UFelipeJR/CubeSat_UD34/README.md

# OBC del CubeSat UD34 — Práctica 4

**Integrantes:** José Manuel Arias Toro y Felipe Jiménez Ramírez  
**Universidad:** Universidad de Antioquia  
**Curso:** Laboratorio de Diseño de Productos Electrónicos  
**Herramienta:** Altium Designer 26

## Descripción

En esta práctica desarrollamos el esquema eléctrico de la tarjeta OBC (On-Board Computer) del CubeSat UD34. La tarjeta utiliza el STM32N657X0H3Q para coordinar el procesamiento, el almacenamiento de datos, el manejo de la cámara, los buses de comunicación y el monitoreo de alimentación.

Separamos el circuito en una hoja principal y varias hojas por función: alimentación, núcleo del MCU, SDRAM, almacenamiento, interfaz de cámara, buses de sistema, supervisión y conector de apilamiento. Las interfaces CAN-FD e I²C utilizan hojas reutilizables con instancias independientes.

## Archivos de soporte

Todos los archivos requeridos estan en la carpeta Archivos

## Proyecto de Altium

El proyecto nativo se abre con desde archivos y descomprimiendo 00_Proyecto_nativo.zip, este contiene `p4_v07_Arias_Jimenez.PrjPcb` desde Altium Designer 26. La hoja raíz es `00_OBC_Top.SchDoc`. Las ocho hojas funcionales y las dos subhojas repetidas forman parte del mismo proyecto.Todas las librerias externas estan en 04_Librerias

## 💡 Indice
- [📄 Archivos ](Archivos)
