UFelipeJR/CubeSat_UD34/Archivos/02_BOM_y_Costos/BOM_Altium_Exportada.xlsx

Name | Description | Designator | Footprint | LibRef | Quantity | Value | Manufacturer | Manufacturer Part Number
0Ω | Chip Resistor, 10 KOhm, +/- 1%, 0.1 W, -55 to 155 degC, 0402 (1005 Metric), RoHS, Tape and Reel | R712 | RESC1005X40X25LL05T05 | CMP-2000-07588-1 | 1 |  | Panasonic
1kΩ, | RES 1kΩ ±0.5% 0.063W 0402 | R18 | FP-AC0402-IPC_A | CMP-03412-044280-1 | 1
1nF | Chip Capacitor, 1 nF, +/- 10%, 50 V, -55 to 125 degC, 0402 (1005 Metric), RoHS, Tape and Reel | C12, C13 | CAPC1005X55X25ML5T10 | CMP-1662-00017-1 | 2
1nF | Chip Multilayer Ceramic Capacitors for General Purpose, 0402, 0.10uF, X7R, 15%, 10%, 50V | C303, C304, C305 | FP-GRM155-0_05-IPC_B | CMP-2008-04639-2 | 3
1uF | Multilayer Ceramic Capacitors 1μF ±10% 16V X7R SMD 0603 | C6, C7, C8, C9, C10, C11, C22, C23, C30, C31, C32, C33, C34, C35, C36, C37, C38, C58, C59 | FP-C1608-080-0_1-IPC_B | CMP-08246-002727-1 | 19
1uH | FIXED IND 1UH 4A 37 MOHM SMD | L2 | INDC3225X120N | TFM322512ALVA1R0MTAA | 1
2,2kΩ | Chip Resistor, 10 KOhm, +/- 1%, 0.1 W, -55 to 155 degC, 0402 (1005 Metric), RoHS, Tape and Reel | R502, R503, R504, R505, R511, R512, R605_I2C_ADCS, R605_I2C_SYS, R606_I2C_ADCS, R606_I2C_SYS, R607_I2C_ADCS, R607_I2C_SYS, R608_I2C_ADCS, R608_I2C_SYS | RESC1005X40X25LL05T05 | CMP-2000-07588-1 | 14 |  | Panasonic
2,2nF | Chip Multilayer Ceramic Capacitors for General Purpose, 0402, 2200pF, X7R, 15%, 10%, 50V | C39 | FP-GRM155-0_05-IPC_B | CMP-2008-04653-5 | 1
2,2uF | Multilayer Ceramic Capacitors 4.7μF ±10% 10V X7R SMD 0805 | C316 | FP-C2012-125-0_2-IPC_B | CMP-08246-006484-1 | 1
2N7002 | MOSFET N-CH 60V 0.3A SOT23 | Q501 | FP-PG-SOT23-3-MFG | CMP-32901-000180-1 | 1
2Ω |  | R14 | RESC1005X40X25NL05T10 | CMP-2002-07059-1 | 1 |  | Yageo / Phycomp
2.2uH | Fixed Inductors 2.2uH Shld 20% 5.5A 38.7mOhms AECQ2 | L1 | FP-XAL4020-MFG | CMP-11268-000134-1 | 1
3,3nF |  | C5 | CAPC1005X55X25ML05T10 | CMP-2008-04658-1 | 1 |  | Murata
3.32 kΩ | Chip Resistor, 10 KOhm, +/- 1%, 0.1 W, -55 to 155 degC, 0402 (1005 Metric), RoHS, Tape and Reel | R2 | RESC1005X40X25LL05T05 | CMP-2000-07588-1 | 1 |  | Panasonic
4,7nF | Chip Multilayer Ceramic Capacitors for General Purpose, 0402, 0.10uF, X7R, 15%, 10%, 50V | C602_CAN_A, C602_CAN_B | FP-GRM155-0_05-IPC_B | CMP-2008-04639-2 | 2
4,7uF | Multilayer Ceramic Capacitors 4.7μF ±10% 10V X7R SMD 0805 | C40, C215, C216, C310 | FP-C2012-125-0_2-IPC_B | CMP-08246-006484-1 | 4
8,2pF | CAP CER 8.2PF 50V C0G/NP0 0402 | C62, C63, C64, C65 | FP-GRM155-0_05-MFG | CMP-2008-03919-2 | 4
10k | Chip Resistor, 10 KOhm, +/- 1%, 0.1 W, -55 to 155 degC, 0402 (1005 Metric), RoHS, Tape and Reel | R9, R15, R16 | RESC1005X40X25LL05T05 | CMP-2000-07588-1 | 3 |  | Panasonic
10kΩ | Chip Resistor, 10 KOhm, +/- 1%, 0.1 W, -55 to 155 degC, 0402 (1005 Metric), RoHS, Tape and Reel | R202, R301, R302, R303, R304, R305, R306, R307, R308, R309, R310, R311, R312, R313, R314, R315, R316, R506, R507, R508, R509, R510, R609_I2C_ADCS, R609_I2C_SYS, R701, R702, R704, R707, R709, R710, R711 | RESC1005X40X25LL05T05 | CMP-2000-07588-1 | 31 |  | Panasonic
10nF | Chip Multilayer Ceramic Capacitors for General Purpose, 0402, 0.10uF, X7R, 15%, 10%, 50V | C505, C507 | FP-GRM155-0_05-IPC_B | CMP-2008-04639-2 | 2
10nF | Chip Multilayer Ceramic Capacitors for General Purpose, 0402, 10000pF, X7R, 15%, 10%, 50V | C61 | FP-GRM155-0_05-IPC_C | CMP-2008-04637-5 | 1
10uF | Multilayer Ceramic Capacitors 10μF ±10% 10V X7R SMD 0805 | C1, C3, C20, C21 | FP-C2012-125-0_2-MFG | CMP-2000-05452-2 | 4
15uF | Multi-Layer Ceramic Capacitor 15uF 6.3V X5R ±10% 1206 Emboss T/R | C26, C27, C28, C29 | FP-GRT31C-0_2-IPC_B | CMP-06035-045968-1 | 4
22uF | Multilayer Ceramic Capacitors 22μF ±20% 10V X7S SMD 0805 | C4 | FP-C2012-125-0_2-IPC_B | CMP-08246-005250-1 | 1
22Ω | Chip Resistor, 10 KOhm, +/- 1%, 0.1 W, -55 to 155 degC, 0402 (1005 Metric), RoHS, Tape and Reel | R201 | RESC1005X40X25LL05T05 | CMP-2000-07588-1 | 1 |  | Panasonic
24MHz | Crystals 24MHz 20ppm 8pF -40C +125C | X1 | ECS240833QJESTR | ECS-240-8-33Q-JES-TR | 1
30,1kΩ | Chip Resistor, 10 KOhm, +/- 1%, 0.1 W, -55 to 155 degC, 0402 (1005 Metric), RoHS, Tape and Reel | R706, R708 | RESC1005X40X25LL05T05 | CMP-2000-07588-1 | 2 |  | Panasonic
32,768kHz | Crystals 32.768 kHz 7.0 pF +/-20 PPM AEC-Q200 | X2 | XTAL_CM7V-T1A-32.768K-7PF-20PPM-TB-QA | CM7V-T1A-32.768K-7PF-20PPM-TB-QA | 1
50m | RES 0.05 OHM 1% 1W 2512 | R1 | FP-WSL2512-MFG | CMP-2000-07420-2 | 1 | 50mΩ | Vishay | WSL2512R0500FEA
60,4Ω | Chip Resistor, 10 KOhm, +/- 1%, 0.1 W, -55 to 155 degC, 0402 (1005 Metric), RoHS, Tape and Reel | R601_CAN_A, R601_CAN_B, R602_CAN_A, R602_CAN_B | RESC1005X40X25LL05T05 | CMP-2000-07588-1 | 4 |  | Panasonic
100 kΩ | Chip Resistor, 10 KOhm, +/- 1%, 0.1 W, -55 to 155 degC, 0402 (1005 Metric), RoHS, Tape and Reel | R4, R6 | RESC1005X40X25LL05T05 | CMP-2000-07588-1 | 2 |  | Panasonic
100k | Chip Resistor, 10 KOhm, +/- 1%, 0.1 W, -55 to 155 degC, 0402 (1005 Metric), RoHS, Tape and Reel | R8, R10, R11, R12 | RESC1005X40X25LL05T05 | CMP-2000-07588-1 | 4 |  | Panasonic
100kΩ | Chip Resistor, 10 KOhm, +/- 1%, 0.1 W, -55 to 155 degC, 0402 (1005 Metric), RoHS, Tape and Reel | R703 | RESC1005X40X25LL05T05 | CMP-2000-07588-1 | 1 |  | Panasonic
100nF | Chip Multilayer Ceramic Capacitors for General Purpose, 0402, 0.10uF, X7R, 15%, 10%, 50V | 201, 202, 203, 204, 205, 206, 207, 208, 209, 210, 211, 212, 213, 214, C14, C15, C16, C17, C18, C19, C24, C25, C41, C42, C43, C44, C45, C46, C47, C48, C49, C50, C51, C52, C53, C54, C55, C56, C57, C60, C301, C302, C306, C307, C308, C309, C311, C312, C313, C314, C501, C502, C503, C506, C508, C601_CAN_A, C601_CAN_B, C602_I2C_ADCS, C602_I2C_SYS, C701, C702, C703, C704, C705, C706 | FP-GRM155-0_05-IPC_B | CMP-2008-04639-2 | 65
100nF | Multilayer Ceramic Capacitors 4.7μF ±10% 10V X7R SMD 0805 | C315 | FP-C2012-125-0_2-IPC_B | CMP-08246-006484-1 | 1
100Ω | Chip Resistor, 10 KOhm, +/- 1%, 0.1 W, -55 to 155 degC, 0402 (1005 Metric), RoHS, Tape and Reel | R705 | RESC1005X40X25LL05T05 | CMP-2000-07588-1 | 1 |  | Panasonic
124k | Chip Resistor, 10 KOhm, +/- 1%, 0.1 W, -55 to 155 degC, 0402 (1005 Metric), RoHS, Tape and Reel | R7 | RESC1005X40X25LL05T05 | CMP-2000-07588-1 | 1 |  | Panasonic
143 kΩ | Chip Resistor, 10 KOhm, +/- 1%, 0.1 W, -55 to 155 degC, 0402 (1005 Metric), RoHS, Tape and Reel | R3 | RESC1005X40X25LL05T05 | CMP-2000-07588-1 | 1 |  | Panasonic
200kΩ | Chip Resistor, 10 KOhm, +/- 1%, 0.1 W, -55 to 155 degC, 0402 (1005 Metric), RoHS, Tape and Reel | R501 | RESC1005X40X25LL05T05 | CMP-2000-07588-1 | 1 |  | Panasonic
200Ω |  | R17 | RESC1005X40X25ML05T10 | CMP-2002-07498-1 | 1 |  | Yageo / Phycomp
215 kΩ | Chip Resistor, 10 KOhm, +/- 1%, 0.1 W, -55 to 155 degC, 0402 (1005 Metric), RoHS, Tape and Reel | R5 | RESC1005X40X25LL05T05 | CMP-2000-07588-1 | 1 |  | Panasonic
390k | Chip Resistor, 10 KOhm, +/- 1%, 0.1 W, -55 to 155 degC, 0402 (1005 Metric), RoHS, Tape and Reel | R13 | RESC1005X40X25LL05T05 | CMP-2000-07588-1 | 1 |  | Panasonic
150060GS75000 | 430mcd Colorless transparence 520nm Emerald 140° LED0603 Light Emitting Diodes (LED) ROHS | D2 | WL-SMCW_0603_150060xx75000 | CMP-1426-00002-6 | 1
61300211121 | THT Vertical Pin Header WR-PHD, Pitch 2.54 mm, Single Row, 2 pins | JP1, JP2, JP701 | 61300211121 | CMP-1712-00002-7 | 3
61300311121 | THT Vertical Pin Header WR-PHD, Pitch 2.54 mm, Single Row, 3 pins | J2 | 61300311121 | CMP-1502-01062-4 | 1
BAT54 | Silicon Schottky Diode, SOT23, Reel, Green | D301, D302 | INF-SOT23_L | CMP-1182-00010-1 | 2 |  | Infineon
CYRS17B01G-133AZMB |  | U301 | CYRS17B01G_TQFP100 | CYRS17B01G-133AZMB | 1
ESQ-126-39-G-D | Description | H1, H2 | CONN_ESQ-126-39-G-D_SAI | ESQ-126-39-G-D | 2
FH12-30S-0.5SH(55) | 30 Position FFC, FPC Connector Contacts, Bottom 0.020 (0.50mm) Surface Mount, Right Angle | J501 | HIROSE_FH12-30S-0.5SH(55) | FH12-30S-0.5SH(55) | 1
FTSH-105-01-L-DV-K | CONNECTOR; MALE; SMT; 0.05 (1.27MM) SMT MICRO HEADER; STRAIGHT; 10PINS | J1 | CON10_2X5_DUK_FTSH_SAI | FTSH-105-01-L-DV-K | 1
GRM155R71H104KE14D | Chip Multilayer Ceramic Capacitors for General Purpose, 0402, 0.10uF, X7R, 15%, 10%, 50V | C2 | FP-GRM155-0_05-IPC_B | CMP-2008-04639-2 | 1
INA226AIDGSR | High-Side Measurement, Bi-Directional Current / Power Monitor with I2C Interface, 2.7 to 5.5 V, -40 to 125 degC, 10-pin SOP (DGS10), Green (RoHS & no Sb/Br) | U2 | DGS0010A_L | CMP-0704-00058-2 | 1
IS42S32160F-6BLI | DRAM SDRAM,512M,3.3V,RoHs 166MHz,16Mx32, IT | U201 | BGA90C80P9X15_800X1300X120 | IS42S32160F-6BLI | 1
MPZ2012S101AT000 | FERRITE BEAD 100 OHM 0805 1LN | FB1 | FP-MPZ2012-MFG | CMP-2000-06751-2 | 1
MX52LM08A11XVI | No Description Available | U302 | 153BGA_11p5x13x1_MAC | MX52LM08A11XVI | 1
PCA9306DCUR | IC TRNSLTR BIDIRECTIONAL 8VSSOP | U501 | FP-DCU0008A-IPC_B | CMP-0314-00419-3 | 1
SMBJ100A-E3/52 | 600W,100V 5%,UNIDIR,SMB TVS | D1 | CR_00A-E352_VIS | SMBJ100A-E352 | 1
SN74AVC4T774PWR | Four-bit dual-supply bus transceiver with configurable voltage-level shifting and tri-state outputs 16-TSSOP -40 to 85 | U502 | PW16 | SN74AVC4T774PWR | 1
STM32N657X0H3Q | High performance Arm Cortex-M55 MCU, 800MHz, 4.2MB SRAM, Neural-ART accelerator 600 GOPS, NeoChrom GPU, JPEG Codec, H-264 enc, HW crypto | U8 | VFBGA264_14X14_STM | STM32N657X0H3Q | 1
TCA4307DGKR | 2-bit bidirectional 2.3-V to 5.5-V, hot-swappable 400-kHz I<sup>2</sup>C/SMBus buffer with stuck- 8-VSSOP -40 to 125 | U603_I2C_ADCS, U603_I2C_SYS | SOIC8_DGK_TEX | TCA4307DGKR | 2
TCAN334GDR | IC TRANSCEIVER 1/1 8SOIC | U601_CAN_A, U601_CAN_B | FP-D0008A-IPC_B | CMP-04872-000213-1 | 2
TLV75518PDBVR | IC REG LINEAR 1.8V 500MA SOT23-5 | U4, U5 | FP-DBV0005A-IPC_A | CMP-04917-000157-1 | 2
TMP117AIDRVR | TEMPERATURE SENSOR | U702 | FP-DRV0006A-MFG | CMP-04948-000009-1 | 1 |  | Texas Instruments | TMP117AIDRVR
TPS3851G18EDRBR | High-accuracy voltage supervisor with Integrated watchdog timer 8-SON -40 to 125 | U701 | DRB0008A | TPS3851G18EDRBR | 1
TPS22918DBVR | IC SINGLE CHANNEL LOAD SWITCH | U6, U7 | FP-DBV0006A-MFG | CMP-04910-000024-2 | 2
TPS62130ARGTR | IC REG BUCK ADJUSTABLE 3A 16QFN | U3 | FP-RGT0016C-MFG | CMP-04918-000067-1 | 1 |  | Texas Instruments | TPS62130ARGTR
TPS259470ARPWR | 2.7-V to 23-V, 28-mâ„|, 5.5-A eFuse with integrated reverse polarity protection 10-VQFN-HR -40 to 125 | U1 | RPW0010A-MFG | TPS259470ARPWR | 1
