UFelipeJR/CubeSat_UD34/Archivos/Tablas/Tabla de Componentes.xlsx

Subsistema | Componente de referencia | Datos importantes para nuestro diseño | Decisión preliminar
Payload – sensor | Teledyne e2v Emerald Gen2 12M USV | Sensor CMOS de 4096×3072, píxel de 2.8 µm, 8/10/12 bits, global shutter, <1.2 W, encapsulado 20×21 mm, LVDS/MIPI CSI-2, SPI/I²C. Es una versión upscreened for space con flujos ECSS/NASA disponibles. | Seleccionado provisionalmente. No es multiespectral por sí solo: necesita óptica + matriz/filtros espectrales visible/NIR. Es mucho más compatible con un 1U que una cámara completa de 1U.
OBC – procesador | Microchip SAMRH71 | ARM Cortex-M7 rad-hard, 100 MHz, 384/768 kB SRAM, QSPI, SPI, I²C, UART, CAN-FD y SpaceWire. TID 100 krad; sin SEL por debajo de LET 62.5 MeV·cm²/mg. Operación -55 a +125 °C. (Microchip) (https://www.microchip.com/en-us/product/samrh71?utm_source=chatgpt.com) | Seleccionado. Sustituiría la referencia genérica al Cortex-M4 que teníamos en el informe.
Almacenamiento | Infineon CYRS17B01G-133UZMB | NOR Flash rad-hard de 1 Gbit = 128 MB por chip, QSPI 125/133 MHz, 2.97–3.63 V, -55 a +125 °C, TID >300 krad, inmunidad SEL >80 LET y SEU immune. (Infineon) (https://www.infineon.com/part/CYRS17B01G-133UZMB?utm_source=chatgpt.com) | Seleccionado. Inicialmente usaría 4 dispositivos = 512 MB, pero la cantidad final debe salir del presupuesto real de imágenes.
EPS + batería | ISISPACE ICEPS2 Type A | EPS específico para 1U–3U. Integra batería, MPPT hardware, calefactor, protecciones, watchdog, housekeeping, buses de 3.3 V y 5 V e I²C. Type A: 184±5 g, 96×92×26.45 mm, página actual declara 22.5 Wh. (Isispace) (https://www.isispace.nl/product/compact-electrical-power-system/?utm_source=chatgpt.com) | Muy buen candidato base. Simplifica muchísimo PCB de potencia y hace concretas las interfaces. Hay que comprobar volumen antes de congelarlo definitivamente.
Generación solar | AZUR SPACE 3G30A-Advanced 4×8 | Celda triple unión InGaP/GaAs/Ge espacial, ECSS cualificada, TRL9. Assembly: 40.15×80.15 mm, 3.6 g, Vmp 2.411 V, Imp 499 mA, eficiencia BOL típica 29.2 %. | Seleccionada. Cada una produce aproximadamente 1.20 W en las condiciones BOL del fabricante; dos sobre una cara representan ~2.4 W de pico ideal.
Telemetría/telecomando UHF | GomSpace NanoCom AX100 | 430–440 MHz, 0.1–38.4 kbps en la especificación actual, 24–30 dBm RF, I²C/UART/CAN, 65×40×6.5 mm y 24.5 g. Temperatura -30 a +85 °C. (GomSpace) (https://gomspace.com/product/nanocom-ax100/?utm_source=chatgpt.com) | Seleccionado para TT&C, no como enlace principal de imágenes.
Antena UHF | ISISPACE VHF/UHF Antenna 1U–3U | 98×98×7 mm plegada, <90 g, 145–868 MHz, UHF 0 dBi, potencia RF máxima 2 W, I²C, <40 mW nominal en versión 3.3 V y 2 W sólo durante despliegue. (Isispace) (https://www.isispace.nl/product/vhf-uhf-antenna-for-1u-3u/?utm_source=chatgpt.com) | Seleccionada. Compatible con la banda UHF del AX100.
Downlink de imágenes | AAC Clyde Space PULSAR-HSTX-C | S-band 2.2–2.3 GHz, hasta 8 Mbps, 24–30 dBm, <5 W a máxima potencia, <100 g, 96×90×17.41 mm, alimentación 6–12 V o variante 5 V, vida de diseño de 2 años en LEO. (AAC Clyde Space) (https://www.aac-clyde.space/what-we-do/space-products-components/communications/pulsar-hstx) | Seleccionado provisionalmente. Soluciona el cuello de botella que tendríamos intentando bajar imágenes por UHF.
Antena S-band | AAC Clyde Space PULSAR-SANTC | Patch para 2.2–2.3 GHz, ganancia 7 dBi, beamwidth 60°, <50 g, temperatura -40 a +85 °C y vida >2 años LEO. (AAC Clyde Space) (https://www.aac-clyde.space/what-we-do/space-products-components/communications/pulsar-sant) | Seleccionada junto al HSTX-C. Debe ir orientada hacia nadir durante el enlace.
Magnetómetro | AAC Clyde Space MM200 | 20×20×11.3 mm en versión mínima, ~10 g, I²C, hasta 500 Hz, rango ±800 µT, 1.18 nT/√Hz y tolerancia hasta 30 krad; TRL9. (AAC Clyde Space) (https://www.aac-clyde.space/what-we-do/space-products-components/adcs/mm200?utm_source=chatgpt.com) | Seleccionado. Sensor principal de campo magnético para ADCS.
Giróscopo | AAC Clyde Space PG400 | ±125 °/s, 280 mW, RS-422, 5 V típico, -40 a +85 °C, probado a 50 krad y diseñado para 5 años LEO. (AAC Clyde Space) (https://www.aac-clyde.space/what-we-do/space-products-components/adcs/pg400-gyroscope) | Seleccionado. Mucho más defendible que poner simplemente “IMU de 9 ejes” sin referencia.
Sensores solares | AAC Clyde Space SS200 | 24.66×15×3.5 mm, 3 g, 5 V, 2.5–40 mW, I²C, FOV 110°, precisión <0.3° (1σ en ±45°), >36 krad y TRL9. (AAC Clyde Space) (https://www.aac-clyde.space/what-we-do/space-products-components/adcs/ss200?utm_source=chatgpt.com) | Seleccionada la familia. La cantidad exacta se fija al diseñar cobertura de caras; probablemente varios sensores.
Control fino de actitud | 3 × AAC Clyde Space RW210 | Rueda para CubeSat de 25×25×15 mm; variantes de 21/32/48 g, hasta 0.1 mN·m de torque, I²C, <800 mW pico, componentes >36 krad. Diseñada para 1–3U. (AAC Clyde Space) (https://www.aac-clyde.space/wp-content/uploads/2021/11/RW210.pdf?utm_source=chatgpt.com) | Seleccionada la familia, tres unidades. La variante de momento exacta debe salir del cálculo de inercia del UD34.
Descarga de momento / detumbling | 3 × CubeSpace CubeTorquer CR0002 | Cada rod: 0.2 A·m² a 5 V, 16.5 g y 10.5×10.5×47 mm. La familia está calificada para vibración NASA GEVS y TVAC; CubeSpace recomienda 0.2–0.4 A·m² para satélites de hasta 6U. (CubeSpace) (https://www.cubespace.co.za/uploads/baa49ac8-46e7-45d0-8844-8b1a2ae7dc03.pdf?utm_source=chatgpt.com) | Seleccionado como actuador magnético. Tres rods son mucho más ligeros que la placa iMTQ de 196 g y encajan mejor con nuestra PCB ADCS propia.
