UFelipeJR/CubeSat_UD34/Archivos/01_Restricciones_y_Calculos/Matriz_restricciones_calculos_y_fabricacion.xlsx

Sheet: Restricciones_PCB
ID y origen | Subsistema / redes | Restricción | Criterio | Clasificación | Fuente técnica | Mecanismo de aplicación en PCB | Método de comprobación
PCB-01 / Carga útil | CSI_CKP/N, CSI_D0P/N, CSI_D1P/N | Impedancia diferencial de pares MIPI CSI-2 | 100 Ω ±10 % | Exigencia técnica | ST AN5967 Rev. 6 | Clase CSI y regla Differential Pairs Routing | Cálculo de impedancia con apilamiento y DRC
PCB-02 / Carga útil | Pares CSI-2 | Diferencia máxima de longitud entre P y N | 0,127 mm | Exigencia técnica | ST AN5967 Rev. 6 | Matched Length en cada par | Medición de longitudes y DRC
PCB-03 / Carga útil | CSI-2 reloj/datos | Diferencia de longitud entre reloj y datos | 2,54 mm | Exigencia técnica | ST AN5967 Rev. 6 | Matched Length de clase CSI | Medición de longitudes y DRC
PCB-04 / Carga útil | CSI-2 MCU–J501 | Longitud y cantidad de vías en enlace | ≤203 mm; ≤2 vías por línea | Exigencia técnica | ST AN5967 Rev. 6 | Regla Length y control de vías | DRC, medición e inspección
PCB-05 / Carga útil | CSI-2 | Plano GND continuo bajo los pares | Sin cortes del retorno | Recomendación adoptada | ST AN5967 Rev. 6 | Nota de diseño y plano de referencia | Inspección de retorno y cambios de capa
PCB-06 / RF-03 | FMC / SDRAM | Carga capacitiva del bus a frecuencia nominal alta | ≤20 pF por señal para 166 MHz | Condición técnica | STM32N6 DS14791, tablas 87 y 89 | Nota de carga máxima de señal | Estimación de pista, pines y parásitos
PCB-07 / RF-03 | FMC / SDRAM | Mantener grupos de datos, control y reloj con longitudes coordinadas | Igualación relativa a SDCLK | Recomendación adoptada | ST AN5967 y hoja IS42S32160F | Clase SDRAM y reglas Matched Length | Comparación de longitudes y DRC
PCB-08 / RF-03 | XSPI NOR | Trayectorias cortas de reloj y señales de datos | Reloj y datos coordinados | Recomendación adoptada | STM32N6 RM0486 y CYRS17B01G | Clase NOR y restricciones de longitud | Medición y revisión de retornos
PCB-09 / RF-03 | SDMMC1 / eMMC | Coordinar longitudes de reloj y datos del bus de ocho bits | Rutas cortas y coordinadas | Recomendación adoptada | STM32N6 RM0486 y hoja MX52LM08A11XVI | Clase eMMC y restricciones de longitud | Medición y revisión de integridad
PCB-10 / IF-01 | 3V3_OBC | Caída de tensión en distribución de alimentación | ≤1 % de 3,3 V (0,033 V) | Criterio adoptado | Cálculo resistivo, hoja Calculos | Clase de potencia y Width | Estimación de caída de tensión
PCB-11 / IF-01 | 3V3_OBC | Sección de cobre para límite de 1 A | Ancho objetivo calculado en hoja Calculos | Criterio adoptado | Cálculo resistivo, cobre 35 µm | Regla Width | Comparar ancho, temperatura y caída
PCB-12 / Alimentación | MCU SMPS / inductores / capacitores | Reducir área de lazo en conversión conmutada | Lazo de corriente mínimo | Exigencia/recomendación | ST AN5967 Rev. 6 | Nota de colocación de potencia | Inspección de disposición y planos
PCB-13 / Alimentación | Todos los pines de alimentación BGA | Desacoplos cercanos y retornos a GND | Ubicación junto a pines | Exigencia/recomendación | ST AN5967 Rev. 6 | Nota de colocación y planos | Inspección de placement
PCB-14 / Reloj | HSE y LSE | Cristales cerca del microcontrolador | Pistas cortas y entorno a GND | Recomendación adoptada | ST AN5967 Rev. 6 | Nota de colocación y separación | Inspección de zona de osciladores
PCB-15 / Cámara | CSI_REXT | Resistor de referencia y retorno próximo | 200 Ω, tolerancia 1 % | Exigencia técnica | STM32N6 DS14791 / AN5967 | Nota de colocación | Verificación de BOM y esquema
PCB-16 / IF-04 | CAN_A_H/L y CAN_B_H/L | Terminación dividida del bus CAN cuando la placa sea extremo de bus | 2 × 60,4 Ω en serie (~120,8 Ω) | Configuración de esquema | Hoja de datos TCAN334; diseño de canales CAN | Nota de condición de montaje | Revisión de topología y nodos extremos
PCB-17 / ADCS | Circuitos ADC y 1V8 analógico | Separar retornos sensibles de conmutación de potencia | Retornos próximos y desacoplo local | Recomendación adoptada | ST AN5967 Rev. 6 | Reglas de ubicación y referencia GND | Inspección de la disposición

Sheet: Fabricacion_Referencia
Característica | Referencia técnica o servicio | Valor / capacidad | Unidad | Fuente (URL) | Uso en el diseño
Proveedor de referencia | JLCPCB | PCB multicapa |  | https://jlcpcb.com/capabilities/pcb-capabilities/ | Servicio de fabricación de referencia
Fecha de consulta | Ficha 6 capas | 26-10-2026 |  | https://jlcpcb.com/resources/6-layer-pcbs | Referencia documental
Número de capas | Configuración de diseño | 6 | capas | https://jlcpcb.com/resources/6-layer-pcbs | Propuesta para planos de retorno y ruteo
Material base | PCB 6 capas | FR-4 |  | https://jlcpcb.com/resources/6-layer-pcbs | Material del apilamiento
Espesor disponible | PCB 6 capas | 1,6 | mm | https://jlcpcb.com/resources/6-layer-pcbs | Opción del servicio de 6 capas
Cobre exterior | PCB 6 capas | 1 oz (35) | µm | https://jlcpcb.com/resources/6-layer-pcbs | Supuesto de cálculo de potencia
Cobre interior disponible | PCB 6 capas | 0,5/1/2 oz |  | https://jlcpcb.com/resources/6-layer-pcbs | Opciones de apilamiento
Pista/espacio mínimos | Multicapa 1 oz | 0,09 / 0,09 | mm | https://jlcpcb.com/capabilities/pcb-capabilities/ | Límite de capacidad de fabricación
Taladro metalizado mínimo | Multicapa | 0,15 | mm | https://jlcpcb.com/capabilities/pcb-capabilities/ | Límite de fabricación
Vía mínima | Taladro / diámetro | 0,15 / 0,25 | mm | https://jlcpcb.com/capabilities/pcb-capabilities/ | Límite de fabricación
Anillo anular PTH | Multicapa 1 oz, recomendado | 0,20 | mm | https://jlcpcb.com/capabilities/pcb-capabilities/ | Regla recomendada de pads
Separación pad-pista | Multicapa 1 oz | 0,10 | mm | https://jlcpcb.com/capabilities/pcb-capabilities/ | Regla de clearance
Puente de máscara | Cobre 1 oz, máscara verde | 0,10 | mm | https://jlcpcb.com/capabilities/pcb-capabilities/ | Separación de máscara entre pads
Máscara-pista cercana | Soldermask opening a pista | ≥0,09 | mm | https://jlcpcb.com/capabilities/pcb-capabilities/ | Regla de clearance de máscara
Impedancia controlada | Servicio 6 capas | Disponible |  | https://jlcpcb.com/resources/6-layer-pcbs | Pares MIPI de 100 ohm diferencial
Pad BGA mínimo | Servicio 6 capas | 0,25 | mm | https://jlcpcb.com/resources/6-layer-pcbs | Escape de VFBGA264

Sheet: Calculos
Parámetro | Valor | Unidad | Fundamento / ecuación
Corriente de cálculo | 1 | A | Límite de corriente de 3V3_OBC
Resistividad de cobre | 1.72e-08 | Ω·m | Valor a ~20 °C
Longitud supuesta | 50 | mm | Longitud utilizada en estimación
Espesor de cobre | 35 | µm | Supuesto de 1 oz
Caída de tensión máxima | 0.033 | V | 1 % de 3,3 V
Anchura por caída de tensión | 0.745 | mm | w = (ρ · L · I) / (t · ΔV)
Anchura por criterio térmico | 0.300 | mm | Referencia de cálculo IPC-2221 en matriz original, ΔT = 10 °C
Mayor ancho resultante | 0.745 | mm | MAX de los dos criterios
Ancho objetivo redondeado | 0.800 | mm | Redondeo al décimo de milímetro superior
Terminación CAN dividida | 120.800 | Ω | 2 × 60,4 Ω
Relación divisor ADC 3V3/5V | 0.249 | V/V | R inferior / (R superior + R inferior)
ADC para riel 3V3 | 0.823 | V | 3,3 V × relación divisor
ADC para riel 5V | 1.247 | V | 5 V × relación divisor
ADC para riel 1V8 | 0.900 | V | 1,8 V × (10 / (10+10))
