UFelipeJR/CubeSat_UD34/Archivos/Tablas/Presupuestos_y_Matrices_DiseñoLab3.xlsx

Sheet: TOC_Resumen
Proyecto CubeSat UD34 - Hoja de Cálculo de Arquitectura y Presupuestos
Basado exclusivamente en el documento de diseño 'DiseñoLab3.txt' | Versión 1.0 (Septiembre 2026)
INFORMACIÓN GENERAL DEL PROYECTO
Proyecto: | Nanosatélite CubeSat UD34 (Práctica 3)
Misión: | Monitoreo multiespectral de regiones de cultivo de café en Colombia
Institución: | Universidad de Antioquia - Dpto. de Ingeniería Electrónica y Telecomunicaciones
Integrantes: | Felipe Jiménez Ramírez y Jose Manuel Arias Toro
Fuente de Datos: | DiseñoLab3.txt (Basado estrictamente en este documento de diseño)
Fecha de Edición: | Septiembre de 2026
TABLA DE CONTENIDOS Y NAVEGACIÓN DIRECTA
N° Pestaña | Nombre de la Pestaña | Descripción de Contenido | Tablas Incluidas | Enlace
1 | Supuestos_y_Requisitos | Supuestos de misión (SUP) y matrices de Requisitos Funcionales (RF), No Funcionales (RNF), Ambientales (RA) y Normativos (RN). | Tablas 1, 2, 3, 4 | Ir a la pestaña →
2 | Especificaciones_Tecnicas | Matriz de especificaciones técnicas parametrizadas y su trazabilidad explícita a requisitos por subsistema. | Tabla 5 | Ir a la pestaña →
3 | Distribucion_HW_SW | Reparto preliminar de funciones entre hardware dedicado y software de abordo. | Tabla 6 | Ir a la pestaña →
4 | Matriz_Seleccion_Arq | Matriz comparativa cuantitativa entre Alternativa A (4 PCBs) y Alternativa B (2 PCBs) con fórmulas de ponderación. | Tabla 7 | Ir a la pestaña →
5 | PCBs_y_Componentes | División funcional de las 4 PCBs apiladas en PC-104 y listado de componentes críticos de referencia. | Tablas 8, 9 | Ir a la pestaña →
6 | Matriz_Interfaces | Matriz detallada de interfaces electrónicas, buses (I2C, SPI, QSPI, CAN) y niveles eléctricos (IF-01 a IF-17). | Tabla 10 | Ir a la pestaña →
7 | Presupuestos_Recursos | Presupuestos de potencia, masa, volumen y energía por órbita junto con el presupuesto de datos y memoria. | Tablas 11, 12 | Ir a la pestaña →
8 | Riesgos_y_TBDs | Asuntos pendientes por definir (TBD-01 a TBD-07) y matriz de riesgos técnicos preliminares. | Tablas 13, 14 | Ir a la pestaña →
CONVENCIONES Y CÓDIGO DE COLORES DEL LIBRO
 | Celda de Entrada / Parámetro Modificable | Valores cuantitativos de entrada o especificaciones del satélite.
 | Celda Calculada por Fórmula (=SUMA, =SUMAPRODUCTO, etc.) | Resultados de balances energéticos, masa total, datos y puntajes ponderados.
 | Encabezado Principal de Tabla | Identificación de columnas y secciones oficiales del documento.
 | Encabezado de Sección | División lógica dentro de cada hoja de trabajo.

Sheet: Supuestos_y_Requisitos
Supuestos de Misión y Matriz de Requisitos
Requisitos Funcionales (RF), No Funcionales (RNF), Ambientales (RA) y Normativos (RN)
TABLA 1: Tabla de supuestos de misión y operación para el CubeSat UD34.
Código | Supuesto | Descripción y alcance
SUP-01 | Órbita SSO nominal | Se adopta como supuesto de diseño una órbita heliosíncrona circular a 550 km de altitud y una inclinación aproximada de 97.5°, buscando condiciones de iluminación relativamente consistentes durante las pasadas ópticas.
SUP-02 | Visibilidad de estación terrestre | Se estiman entre 2 y 4 pases diarios útiles sobre la estación terrestre de Medellín, con ventanas aproximadas de 8 a 10 minutos por pase.
SUP-03 | Resolución espacial de la carga útil | Se establece como objetivo preliminar una resolución espacial multiespectral inferior a 15 m por píxel. El volumen de datos por imagen se calculará posteriormente a partir del sensor y la configuración multiespectral utilizados como referencia.
SUP-04 | Perfil simplificado de eclipse | Para los cálculos preliminares se adopta una órbita nominal de 90 minutos, con 55 minutos de iluminación y 35 minutos de eclipse, y una profundidad de descarga máxima objetivo del 30%.
TABLA 2: Requisitos funcionales del sistema CubeSat UD34 (RF-01 a RF-08).
ID | Requisito | Origen o justificación | Prioridad | Criterio de aceptación
RF-01 | Adquirir imágenes multiespectrales de regiones de interés terrestre. | Misión principal. | Alta | Demostrar la recepción y el almacenamiento correcto de datos procedentes de la cámara multiespectral.
RF-02 | Almacenar temporalmente imágenes y datos de estado a bordo. | Conservación de información antes de transmitirla. | Alta | Verificar que la memoria a bordo almacene íntegramente los datos acumulados entre ventanas de descarga.
RF-03 | Transmitir información a la estación terrestre y recibir instrucciones de control. | Comunicación bidireccional. | Alta | Establecer un enlace bidireccional mediante prueba de RF en banco y simulación de pase.
RF-04 | Determinar y modificar la orientación espacial para la captura de imágenes y la operación del satélite. | Apuntamiento de carga útil y operación. | Alta | Verificar el funcionamiento de sensores y actuadores de orientación dentro de los límites establecidos.
RF-05 | Generar, almacenar y distribuir energía eléctrica a todos los subsistemas. | Operación autónoma con paneles solares y baterías. | Alta | Demostrar operación continua mediante paneles solares, batería y regulación de potencia.
RF-06 | Medir y reportar datos de estado e ingeniería de los subsistemas del satélite. | Supervisión desde tierra. | Media | Generar tramas periódicas de housekeeping e integrarlas al enlace descendente.
RF-07 | Procesar y administrar los datos generados por la cámara multiespectral. | Coordinación entre adquisición, memoria y comunicaciones. | Alta | Verificar que el sistema gestione los datos sin pérdida de tramas bajo la carga prevista.
RF-08 | Recibir e interpretar comandos desde la estación terrestre para modificar la operación. | Control posterior al lanzamiento. | Alta | Interpretar y ejecutar correctamente comandos remotos recibidos por el transceptor.
TABLA 3: Requisitos no funcionales del sistema CubeSat UD34 (RNF-01 a RNF-06).
ID | Requisito | Origen o justificación | Prioridad | Criterio de aceptación
RNF-01 | Adaptar el diseño electrónico e integrativo al formato CubeSat 1U. | Restricción geométrica y de masa del estándar CubeSat. | Alta | Validar que la masa total se mantenga dentro del límite aplicable de 2000 g para la referencia CubeSat 1U adoptada y que la integración mecánica corresponda al volumen disponible de 1U.
RNF-02 | Operar dentro del presupuesto energético disponible. | Balance entre generación solar, batería y consumo. | Alta | Verificar mediante balance energético que la generación y el almacenamiento cubran los perfiles de operación y eclipse.
RNF-03 | Mantener operación continua en entorno LEO durante la vida útil especificada. | Vida útil objetivo de 6 meses. | Alta | Demostrar mediante análisis y pruebas que los componentes seleccionados son compatibles con la operación prevista durante 6 meses.
RNF-04 | Utilizar un procesador con capacidad suficiente para coordinar subsistemas y datos. | Coordinación de cámara, almacenamiento y COMMS. | Alta | Justificar que el procesador seleccionado disponga de capacidad de procesamiento e interfaces suficientes para manejar los subsistemas y el flujo de datos previsto.
RNF-05 | Disponer de capacidad de almacenamiento no volátil dimensionada según la generación y descarga de datos. | Conservación de imágenes antes de la descarga. | Alta | Verificar que la memoria permita almacenar como mínimo tres días del perfil de datos previsto antes de requerir una descarga a tierra.
TABLA 4: Requisitos ambientales y normativos del CubeSat UD34.
ID | Requisito | Origen o justificación | Prioridad | Criterio de aceptación
RA-01 | Soportar las cargas mecánicas de lanzamiento y operar en alto vacío espacial. | Entorno del vehículo de lanzamiento y órbita LEO. | Alta | Superar el perfil de pruebas mecánicas definido para el proyecto y conservar funcionalidad después de la prueba; verificar compatibilidad con vacío térmico.
RA-02 | Mantener funcionalidad ante ciclado térmico y el entorno de radiación previsto en LEO. | Entorno térmico y espacial LEO. | Alta | Verificar operación estable dentro del rango térmico de diseño de -20\,°C a +70\,°C y aplicar estrategias de mitigación frente a SEE.
RN-01 | Cumplir con la especificación de diseño CubeSat adoptada por el proyecto. | CubeSat Design Specification Rev. 14.1. | Alta | Verificar el diseño mediante la lista de chequeo aplicable de la especificación CubeSat.

Sheet: Especificaciones_Tecnicas
Especificaciones Técnicas y Matriz de Trazabilidad
Parámetros técnicos cuantitativos y su derivación directa desde los requisitos
TABLA 5: Matriz de especificaciones técnicas y trazabilidad del CubeSat UD34.
ID de especificación | Requisitos asociados | Parámetro técnico | Valor o rango | Unidad | Fundamento | Método previsto de verificación
ET-CU-01 | RF-01, RNF-01 | Masa asignada a la carga útil y resolución espacial objetivo | <150; <15 | g; m/píxel | Compatibilidad con la integración 1U y con el objetivo preliminar definido para la adquisición de imágenes multiespectrales. | Inspección física, análisis óptico y prueba en banco.
ET-OBC-01 | RF-07, RNF-04, RNF-05 | Frecuencia del procesador de referencia y capacidad de almacenamiento no volátil | 100; 512 | MHz; MB | Capacidad de procesamiento e interfaces necesarias para coordinar los subsistemas y almacenar temporalmente los datos de misión. | Prueba funcional, verificación de interfaces y ensayo de lectura/escritura de memoria.
ET-EPS-01 | RF-05, RNF-02 | Potencia solar promedio mínima durante iluminación y profundidad de descarga estimada en eclipse | >3.75; ≈ 5.5 | W; % | Valores preliminares derivados del balance energético para una órbita de 90 minutos con 55 minutos de iluminación y 35 minutos de eclipse. | Balance energético, ensayo de potencia y ciclos de carga/descarga.
ET-COM-01 | RF-03, RF-08 | Potencia RF y velocidad máxima del enlace UHF de TT&C | 1.0; 38.4 | W; kbps | Enlace destinado principalmente a telemetría, telecomandos y operación de respaldo. | Medición de potencia y prueba de enlace RF.
ET-COM-02 | RF-03, RF-07 | Velocidad máxima de referencia y tasa mínima requerida para el enlace S-band | 8; 0.46 | Mbps; Mbps | Enlace destinado principalmente a la descarga de imágenes y datos científicos generados por la carga útil. | Prueba de enlace, medición de tasa efectiva y simulación de ventana de comunicación.
ET-ADCS-01 | RF-04 | Precisión de apuntamiento en tres ejes | <2.0 | grados | Alineación de la carga útil hacia la región de interés y apoyo al enlace de comunicaciones. | Simulación o ensayo de actitud en banco.

Sheet: Distribucion_HW_SW
Distribución Preliminar de Funciones entre Hardware y Software
Partición de responsabilidades operativas entre electrónica física y software de vuelo
TABLA 6: Distribución preliminar de funciones entre hardware y software del CubeSat UD34.
p{1.6cm} p{3.0cm} p{3.4cm} X} Función | Tipo de implementación | Recursos de hardware necesarios | Responsabilidad del software futuro | Justificación
Función | Tipo de implementación | Recursos de hardware necesarios | Responsabilidad del software futuro | Justificación
Adquisición de imágenes multiespectrales | Mixta | Cámara multiespectral, interfaz de adquisición de datos, líneas de sincronización y memoria temporal. | Configurar la adquisición, iniciar las capturas según el plan de misión, recibir los datos, verificar su integridad y asociar metadatos a cada imagen. | La formación y digitalización de la imagen dependen del hardware de la carga útil, mientras que el momento de captura y la administración de los datos requieren control programable.
Almacena- miento de imágenes y telemetría | Mixta | Memoria Flash no volátil, interfaz QSPI o equivalente y recursos de transferencia del microcontrolador. | Organizar los datos almacenados, administrar búferes, verificar integridad, controlar prioridades de escritura y decidir qué información debe conservarse o transmitirse primero. | La memoria y la transferencia eléctrica son funciones de hardware, pero la administración de los datos depende de las condiciones de operación de la misión.
Gestión de modos de operación | Software con soporte de hardware | Microcontrolador del OBC, temporizadores, RTC, señales de estado de los subsistemas y watchdog. | Implementar la máquina de estados del satélite, incluyendo modos de operación nominal, adquisición, transmisión, eclipse y modo seguro. | Los cambios entre modos dependen de múltiples variables y deben poder modificarse durante el desarrollo sin rediseñar el hardware.
Supervisión y recuperación ante fallas | Mixta | Watchdog independiente, detector de bajo voltaje, reset y protecciones eléctricas del EPS. | Supervisar estados de error, registrar eventos, reiniciar tareas cuando sea necesario y ordenar la entrada al modo seguro ante condiciones anómalas. | Las protecciones críticas deben poder actuar aun cuando el procesador falle, mientras que el diagnóstico y la recuperación de alto nivel requieren software.
Generación, regulación y distribución de energía | Hardware | Paneles solares, convertidores de potencia, etapa MPPT, batería recargable, BMS, reguladores de 3.3 V y 5 V e interruptores de carga. | Consultar el estado del sistema energético y habilitar o deshabilitar cargas no críticas según el modo de operación. | La conversión y las protecciones eléctricas deben funcionar independientemente del OBC para evitar daños por una falla de software.
Monitoreo del sistema de potencia | Mixta | Sensores de corriente, voltaje y temperatura, ADC e interfaces de comunicación con el OBC. | Leer las mediciones, estimar el estado energético, generar telemetría y determinar cuándo debe reducirse el consumo del satélite. | Las variables eléctricas se adquieren físicamente mediante sensores, pero su interpretación y uso en la gestión de energía requieren procesamiento.
Comunicación con la estación terrestre | Mixta | Transceptor UHF, transmisor S-band, etapas de RF, filtros, adaptación de impedancias y antenas correspondientes. | Construir y procesar tramas de telemetría y telecomandos, administrar la información científica para descarga, verificar la integridad de los paquetes y ejecutar comandos válidos. | La generación y recepción de las señales de radiofrecuencia corresponden al hardware, mientras que la organización de la telemetría, los telecomandos y los datos científicos requiere software.
Determinación de actitud | Mixta | IMU, magnetómetro, sensores solares, convertidores e interfaces digitales hacia el OBC. | Adquirir y combinar las mediciones de los sensores, aplicar calibraciones y estimar la orientación del satélite. | Los sensores proporcionan mediciones físicas, pero la estimación de actitud requiere procesamiento matemático sobre varios datos simultáneamente.
Control de actitud | Mixta | Ruedas de reacción, magnetorquers, etapas de potencia, drivers y señales de control hacia los actuadores. | Calcular la acción de control requerida y generar las consignas necesarias para orientar el CubeSat, además de administrar el detumbling y la descarga de momento de las ruedas. | El software determina la acción de control, mientras que los actuadores y sus etapas de potencia realizan físicamente la modificación de la actitud del satélite.
Generación de telemetría de estado | Software con adquisición por hardware | Sensores distribuidos en EPS, OBC, COMMS, ADCS y carga útil, junto con ADC e interfaces digitales. | Recopilar periódicamente voltajes, corrientes, temperaturas y estados de los subsistemas, empaquetándolos para almacenamiento y transmisión. | La medición depende del hardware de sensado, pero la selección, organización y transmisión de la información se realiza mediante software.

Sheet: Matriz_Seleccion_Arq
Matriz Comparativa Cuantitativa de Arquitecturas
Evaluación ponderada: Alternativa A (4 PCBs) vs Alternativa B (2 PCBs)
TABLA 7: Matriz comparativa cuantitativa entre alternativas de arquitectura para el UD34.
Criterio | Peso (%) | Nota Alt A (1-5) | Nota Alt B (1-5) | Puntaje Ponderado Alt A | Puntaje Ponderado Alt B | Justificación de la Valoración
Modulabilidad y mantenibilidad | 25.0% | 5.0 | 2.0 |  |  | La Alt. A permite reemplazar o reparar una PCB dañada sin afectar los demás subsistemas.
Desacoplamiento de fallas térmicas/eléctricas | 25.0% | 4.5 | 2.0 |  |  | Aislar la etapa RF y el EPS del OBC en la Alt. A previene interferencias y puntos de falla comunes.
Densidad de enrutamiento y complejidad de PCB | 20.0% | 4.0 | 2.5 |  |  | Placas de 4 capas estándar en Alt. A versus diseños complejos de 8 capas con vías ciegas en Alt. B.
Flexibilidad en pruebas AIT (Assembly, Integration & Testing) | 20.0% | 5.0 | 2.0 |  |  | La Alt. A posibilita la verificación funcional paralela e independiente de cada subsistema.
Costo y consumo de masa/volumen | 10.0% | 3.0 | 4.5 |  |  | La Alt. B ahorra masa de conectores, pero incrementa significativamente el riesgo de re-diseño.
PUNTUACIÓN PONDERADA TOTAL |  | -- | -- |  |  | SELECCIÓN DEFINITIVA: Alternativa A (4 PCBs apiladas en Bus PC-104)

Sheet: PCBs_y_Componentes
División en PCBs y Componentes Críticos de Referencia
Estructura física en 4 tarjetas apiladas y selección preliminar de hardware espacial
TABLA 8: División funcional propuesta de la arquitectura electrónica del CubeSat UD34.
p{2.0cm} p{3.5cm} p{3.5cm} X} PCB | Subsistema | Funciones principales | Recursos electrónicos principales | Conexiones relevantes
PCB | Subsistema | Funciones principales | Recursos electrónicos principales | Conexiones relevantes
PCB 1 | EPS | Recibir la energía de los paneles solares, gestionar la batería, regular los rieles de alimentación y distribuir potencia protegida hacia los demás subsistemas. | Etapas de conversión de potencia, gestión de batería, protecciones eléctricas y sensores de voltaje, corriente y temperatura. | Paneles solares, batería, OBC, COMMS y ADCS.
PCB 2 | OBC | Coordinar la operación del CubeSat, administrar los modos de funcionamiento, recibir los datos de la carga útil y los subsistemas, gestionar el almacenamiento y organizar la telemetría y los telecomandos. | Microcontrolador ARM Cortex-M4, memoria no volátil, memoria de trabajo, temporización y watchdog. | Cámara multiespectral, EPS, COMMS, ADCS y memoria de almacenamiento.
PCB 3 | COMMS | Realizar la transmisión y recepción del enlace con la estación terrestre y acondicionar las señales de radiofrecuencia. | Transceptor, etapa de RF, amplificación de potencia, filtrado y adaptación hacia la antena. | OBC, EPS y antena.
PCB 4 | ADCS | Adquirir las variables asociadas a la orientación y accionar las etapas de potencia de los actuadores de actitud. | Interfaces para IMU y sensores solares, generación de PWM y etapas de potencia para los magnetorquers. | OBC, EPS, sensores de orientación y magnetorquers.
TABLA 9: Componentes críticos de referencia para la arquitectura preliminar del CubeSat UD34.
p{3.0cm} p{4.0cm} X} Subsistema | Componente de referencia | Características relevantes | Justificación preliminar
Subsistema | Componente de referencia | Características relevantes | Justificación preliminar
Carga útil | Teledyne e2v Emerald Gen2 12M USV | Sensor CMOS de 4096 x 3072 píxeles, profundidad de 8/10/12 bits, obturador global, interfaces LVDS y MIPI CSI-2, configuración mediante SPI/I2C y consumo inferior a 1.2 W. | Sensor compacto con versión preparada para aplicaciones espaciales. Permite desarrollar una carga útil propia compatible con el reducido volumen disponible en un CubeSat 1U. La óptica y los filtros multiespectrales permanecen por definir.
OBC | Microchip SAMRH71 | Microcontrolador rad-hard ARM Cortex-M7 de hasta 100 MHz, memoria con ECC, interfaces SPI, QSPI, I2C, CAN-FD y SpaceWire. Rango de operación de -55 °C a +125 °C y tolerancia TID de 100 krad(Si). | Proporciona capacidad de procesamiento e interfaces suficientes para coordinar los subsistemas y presenta características específicamente orientadas a aplicaciones aeroespaciales.
Almacena- miento | Infineon CYRS17B01G-133UZMB | Memoria NOR Flash rad-hard de 1 Gbit (128 MB) por dispositivo, interfaz QSPI, frecuencia de hasta 133 MHz, operación a 3.3 V y tolerancia TID superior a 300 krad. | Permite disponer de almacenamiento no volátil resistente a radiación. La cantidad definitiva de dispositivos se determinará mediante el presupuesto de datos de la misión.
EPS y batería | ISISPACE ICEPS2 Type A | Sistema de potencia para CubeSat con batería Li-ion integrada de dos celdas, acondicionamiento de potencia, distribución, protecciones, telemetría e interfaz I2C. Dimensiones aproximadas de 96 x 92 x 26.5 mm y masa aproximada de 184 g. | Permite utilizar una referencia real para determinar las líneas de alimentación, capacidad energética, interfaces de supervisión y volumen ocupado por el EPS.
Generación solar | AZUR SPACE 3G30A-Advanced | Celda solar espacial de triple unión InGaP/GaAs/Ge. Dimensiones aproximadas de 40.15 x 80.15 mm, masa cercana a 3.6 g, V_{mp} aproximado de 2.41 V e I_{mp} aproximado de 0.50 A en condiciones BOL. | Tecnología calificada para aplicaciones espaciales y con alta eficiencia. La cantidad y distribución definitiva de celdas dependerá del área externa disponible y del balance energético orbital.
COMMS -- TT&C | GomSpace NanoCom AX100 | Transceptor UHF configurable con potencia RF ajustable entre 24 y 30 dBm e interfaces I2C, UART y CAN. Dimensiones aproximadas de 65 x 40 x 6.5 mm y masa de 24.5 g. | Adecuado para telemetría, telecomandos y enlace de respaldo debido a su reducido tamaño y a sus interfaces compatibles con sistemas CubeSat.
Antena UHF | ISISPACE VHF/UHF Antenna 1U--3U | Antena desplegable para CubeSat, rango aproximado de 145 a 868 MHz, masa inferior a 90 g, dimensiones plegada de 98 x 98 x 7 mm e interfaz I2C para despliegue. | Compatible con el enlace UHF de telemetría y telecomando y diseñada específicamente para plataformas CubeSat.
COMMS -- Payload | AAC Clyde Space PULSAR-HSTX-C | Transmisor S-band comercial entre 2.2 y 2.3 GHz, modulación QPSK/OQPSK, tasa máxima de transmisión de 8 Mbps, potencia RF ajustable hasta 1 W y consumo total inferior a 5 W. | Permite descargar imágenes a una tasa considerablemente mayor que el enlace UHF, evitando que la transmisión del payload sea el principal cuello de botella de la misión.
Antena S-band | AAC Clyde Space PULSAR-SANTC | Antena patch para 2.2--2.3 GHz, ganancia aproximada de 7 dBi, haz de aproximadamente 60 grados, masa inferior a 50 g y diseño orientado hacia nadir. | Complementa el transmisor S-band y permite establecer un enlace de alta velocidad con la estación terrestre durante las ventanas de visibilidad.
Sensado ADCS | AAC Clyde Space MM200, PG400 y SS200 | Magnetómetro MM200 mediante I2C, giróscopo PG400 mediante RS-422 y sensores solares SS200 mediante I2C. Los dispositivos cuentan con características de tolerancia ambiental y antecedentes de vuelo. | La combinación proporciona referencias independientes del campo magnético, velocidad angular y dirección solar para la estimación de actitud. La cantidad definitiva de sensores solares permanece por definir.
Actuación ADCS | 3 x AAC Clyde Space RW210 | Ruedas de reacción compactas de 25 x 25 x 15 mm, interfaz I2C, torque máximo aproximado de 0.1 mN·m y consumo pico inferior a 800 mW por unidad. | Tres ruedas permiten efectuar control activo de actitud alrededor de los tres ejes principales. La variante de almacenamiento de momento se seleccionará después de estimar la inercia del CubeSat.
Desaturación y detumbling | 3 x CubeSpace CubeTorquer CR0002 | Magnetorquer de 0.20 A·m^2 a 5 V, masa aproximada de 16.5 g y dimensiones de 10.5 x 10.5 x 47 mm por unidad. | Permite realizar detumbling después del despliegue y descargar el momento acumulado por las ruedas de reacción utilizando el campo magnético terrestre.

Sheet: Matriz_Interfaces
Matriz Preliminar de Interfaces del CubeSat UD34
Definición detallada de interconexiones físicas, protocolos y niveles eléctricos (IF-01 a IF-17)
TABLA 10: Matriz preliminar de interfaces del CubeSat UD34.
p{1.15cm} p{1.15cm} X p{1.9cm} p{2.5cm} p{1.7cm} p{2.2cm}} ID | Origen | Destino | Función | Señal o protocolo | Características eléctricas preliminares | Tasa o volumen de datos | Observaciones
ID | Origen | Destino | Función | Señal o protocolo | Características eléctricas preliminares | Tasa o volumen de datos | Observaciones
IF-01 | Emerald 12M USV | Interfaz de Payload | Transferir los píxeles digitalizados desde el sensor de imagen hacia la electrónica de adquisición. | MIPI CSI-2 o LVDS; SPI/I2C para configuración. | Señales diferenciales de alta velocidad. Los rieles de alimentación y niveles definitivos permanecerán TBD hasta disponer del diseño completo de la carga útil. | Aproxima- damente 18.9 MB por imagen completa a 12 bits, antes de compresión. | La interfaz definitiva entre MIPI CSI-2 y LVDS se seleccionará junto con el FPGA o bridge de adquisición.
IF-02 | Interfaz de Payload | OBC | Transferir al computador de a bordo las imágenes adquiridas por la cámara. | SpaceWire propuesto; alternativa TBD durante diseño detallado. | Interfaz diferencial. El SAMRH71 dispone de dos puertos SpaceWire. La adaptación física desde el FPGA deberá definirse en el esquemático. | Hasta 200 Mbps por enlace en el lado del SAMRH71. | Permite desacoplar la adquisición de alta velocidad del procesamiento general realizado por el OBC.
IF-03 | OBC | Memoria Flash | Almacenar imágenes, telemetría, eventos y datos de misión de forma no volátil. | QSPI. | Memoria CYRS17B01G operada alrededor de 3.3 V. Compatible con los niveles de E/S de 3.0 a 3.6 V del SAMRH71. | Reloj QSPI de hasta 133 MHz por dispositivo. | Se considera inicialmente más de un dispositivo para aumentar la capacidad. La cantidad final depende del presupuesto de datos.
IF-04 | ICEPS2 | OBC | Transmitir telemetría del sistema de potencia y recibir comandos de supervisión. | I2C. | Niveles lógicos altos entre 2.3 y 3.3 V. El ICEPS2 opera como nodo esclavo. | 100 kbps en modo estándar o 400 kbps en modo rápido. | Incluye mediciones de voltaje, corriente, temperatura y estados internos del EPS.
IF-05 | ICEPS2 | OBC | Alimentar el computador de a bordo y sus periféricos principales. | Bus de potencia DC. | Dominio regulado de 3.3 V del ICEPS2. Capacidad total del dominio de hasta 4 A. | No aplica. | Los reguladores locales necesarios para el núcleo del SAMRH71 deberán incorporarse en la PCB del OBC.
IF-06 | ICEPS2 | Nano- Com AX100 | Alimentar el transceptor UHF utilizado para telemetría y telecomando. | Bus de potencia DC. | Alimentación nominal de 3.3 V. | No aplica. | La alimentación se mantendrá separada de las líneas RF y contará con desacoplamiento local en la PCB de comunicaciones.
IF-07 | OBC | Nano- Com AX100 | Enviar telemetría y recibir telecomandos del enlace UHF. | CAN-Bus propuesto. | Interfaz diferencial mediante transceptor CAN externo conectado al controlador CAN del SAMRH71. | La tasa del bus interno deberá superar la tasa RF máxima de 38.4 kbps. | Se prefiere CAN frente a una UART simple para mejorar robustez entre PCBs. El bitrate definitivo permanece TBD.
IF-08 | OBC | PUL- SAR-HSTX-C | Transferir los datos científicos almacenados hacia el transmisor S-band y configurar su operación. | SPI para payload e I2C para configuración. | SPI de alta velocidad y bus I2C de baja velocidad. Alimentación lógica según interfaz del transmisor. | SPI de hasta 8 MHz e I2C hasta 400 kHz. | El SPI transporta los datos de imagen mientras el I2C se reserva para configuración y supervisión.
IF-09 | ICEPS2 | PUL- SAR-HSTX-C | Suministrar potencia durante la transmisión de imágenes por S-band. | Bus de potencia DC. | Se utilizará la variante de alimentación regulada a 5 V del transmisor. Consumo máximo inferior a 5 W. | No aplica. | La transmisión representa una de las cargas instantáneas más exigentes del CubeSat y deberá considerarse en el presupuesto energético.
IF-10 | PUL- SAR-HSTX-C | PUL- SAR-SANTC | Transferir la señal de radiofrecuencia hacia la antena S-band. | RF coaxial. | Interfaz de aproximadamente 50 ohm. Frecuencia entre 2.2 y 2.3 GHz. Potencia RF ajustable entre 24 y 30 dBm. | Hasta 8 Mbps de enlace descendente. | La antena se orientará preferiblemente hacia nadir durante los pases sobre la estación terrestre.
IF-11 | Nano -Com AX100 | Antena UHF | Transmitir telemetría y recibir telecomandos mediante el enlace UHF. | RF coaxial. | Interfaz RF de 50 ohm. Banda UHF del AX100 entre 430 y 440 MHz. Potencia de transmisión ajustable entre 24 y 30 dBm. | Entre 0.1 y 38.4 kbps. | Este enlace se mantiene para telecomando, telemetría housekeeping y operación de respaldo.
IF-12 | MM200 y SS200 | OBC / ADCS | Transferir las mediciones del campo magnético terrestre y de la dirección solar utilizadas para estimación de actitud. | I2C. | El SS200 se alimenta a 5 V. La alimentación definitiva del MM200 y los niveles de bus deberán verificarse mediante su ICD antes del diseño esquemático. | Baja tasa; muestreo periódico configurable. | Los sensores pueden compartir el mismo bus si sus direcciones y requisitos eléctricos son compatibles.
IF-13 | PG400 | OBC / ADCS | Transmitir las medidas de velocidad angular del satélite. | RS-422 full duplex. | PG400 alimentado nominalmente a 5 V. Señal diferencial RS-422; requiere transceptor físico entre el sensor y el SAMRH71. | TBD según frecuencia de adquisición seleccionada. | La interfaz diferencial proporciona mayor inmunidad al ruido que una señal UART CMOS directa.
IF-14 | OBC / ADCS | 3 ruedas RW210 | Enviar referencias de velocidad o torque a las ruedas de reacción y recibir su estado. | I2C. | Interfaz I2C compatible. Alimentación y variante exacta de rueda pendientes del dimensionamiento final del ADCS. | Baja tasa de datos; actualización periódica de control. | Cada rueda incorpora control interno, reduciendo la carga de control de bajo nivel sobre el OBC.
IF-15 | OBC / ADCS | Drivers de CubeTorquer | Controlar el momento magnético generado por los tres magnetorquers. | PWM / GPIO hacia etapa de potencia. | Los CubeTorquer CR0002 están especificados para 5 V y aproximadamente 98 mA nominales por actuador. El OBC no los alimenta directamente. | No aplica como enlace de datos. | Se requiere una etapa de potencia bidireccional o puente H para controlar sentido y magnitud promedio de corriente.
IF-16 | Paneles solares | ICEPS2 | Transferir la energía producida por las celdas fotovoltaicas al sistema de acondicionamiento y carga. | Potencia DC. | Voltaje y corriente variables según conexión serie/paralelo, iluminación y temperatura. Configuración definitiva TBD. | No aplica. | La disposición de celdas se definirá mediante el presupuesto energético y el área disponible en las caras del CubeSat.
IF-17 | Antenas | Estación terrestre | Establecer los enlaces externos de telecomando, telemetría y descarga de información científica. | UHF y S-band RF. | UHF para TT&C y S-band comercial entre 2.2 y 2.3 GHz para payload. | Hasta 38.4 kbps en UHF y hasta 8 Mbps en S-band. | La estación de Medellín deberá disponer de capacidad S-band para utilizar el enlace de alta velocidad; esta condición permanece como TBD del segmento terreno.

Sheet: Presupuestos_Recursos
Presupuestos de Potencia, Masa, Volumen y Datos
Estimaciones cuantitativas de recursos orbitales y balance de almacenamiento/telecomunicaciones
TABLA 11: Presupuesto preliminar de potencia y recursos del CubeSat UD34.
Subsistema | Potencia Nominal (W) | Potencia Máxima (W) | Ciclo de Actividad | Energía Estimada (Wh/órbita) | Masa Estimada (g) | Volumen Asignado (U) | Fuente de la Estimación
EPS y batería | 0.093 | 0.200 | 100% | 0.140 | 184 | 0.234 U | Hoja de datos ICEPS2 Type A.
OBC, FPGA y almacenamiento | 0.800 | 1.500 | 100% | 1.200 | 158 | 0.12 U | Hojas de datos de componentes y estimación de PCB.
Carga útil multiespectral | 1.000 | 1.200 | 5% | 0.075 | 150 | 0.15 U | Sensor Emerald 12M USV y estimación óptica.
COMMS UHF | 0.180 | 2.640 | Rx 97.5%; Tx 2.5% | 0.360 | 115 | 0.084 U | NanoCom AX100 y antena UHF de referencia.
COMMS S-band | 0.000 | 5.000 | 2.1% | 0.160 | 150 | 0.15 U | PULSAR-HSTX-C y antena S-band de referencia.
ADCS | 1.000 | 4.600 | 100% | 1.500 | 208 | 0.08 U | RW210, CubeTorquer, MM200, PG400, SS200.
Celdas solares | 0.000 | 1.200 | 61% (iluminado) | 0.000 | 49 | Externo | AZUR SPACE 3G30A-Advanced.
Estructura 1U | 0.000 | 0.000 | 100% | 0.000 | 300 | 1.00 U | Estructura, rieles y separadores.
Arnés e interfaces térmicas | 0.000 | 0.000 | 100% | 0.000 | 120 | 0.08 U | Margen preliminar de integración.
TOTALES DEL SISTEMA |  | -- | -- |  |  | ≈ 1.0 U | Masa dentro del límite de 2000 g (RNF-01)
TABLA 12: Presupuesto preliminar de generación, almacenamiento y transferencia de datos.
Fuente de Datos | Datos por Adquisición (MB) | Adquisiciones Diarias | Volumen Acumulado (MB/día) | Almacenamiento 3 Días (MB) | Tasa Mínima Requerida (kbps)
Carga útil multiespectral | 18.90 | 4 |  |  | 336.0
Housekeeping EPS/OBC | 0.55 | 1 |  |  | 2.5
Datos ADCS | 2.76 | 1 |  |  | 12.3
Registro de eventos | 0.10 | 1 |  |  | 1.0
TOTAL APROXIMADO | -- | --

Sheet: Riesgos_y_TBDs
Asuntos Pendientes (TBDs) y Matriz de Riesgos Técnicos
Parámetros de diseño abiertos y estrategias de mitigación preliminares
TABLA 13: Asuntos pendientes de definición del CubeSat UD34.
p{3.4cm} X X} ID | Asunto pendiente | Razón por la cual permanece abierto | Información o análisis requerido para cerrarlo
ID | Asunto pendiente | Razón por la cual permanece abierto | Información o análisis requerido para cerrarlo
TBD-01 | Configuración óptica de la carga útil multiespectral | El sensor de imagen de referencia no define por sí solo las bandas espectrales ni la óptica necesaria para obtener las imágenes de la misión. | Seleccionar bandas espectrales, filtros y óptica; posteriormente verificar campo de visión, resolución espacial y volumen disponible.
TBD-02 | Dispositivo de adquisición entre cámara y OBC | La salida de alta velocidad de la cámara no es directamente compatible con las interfaces principales del procesador seleccionado. | Seleccionar FPGA o dispositivo bridge y definir la interfaz definitiva entre el sensor, la etapa de adquisición y el OBC.
TBD-03 | Cantidad y distribución de celdas solares | La potencia realmente disponible depende de orientación, iluminación, temperatura y superficie externa ocupada por otros elementos. | Realizar un balance energético orbital y definir la distribución física de paneles o celdas sobre las caras disponibles.
TBD-04 | Configuración final del sistema ADCS | El torque y almacenamiento de momento requeridos dependen de la inercia del CubeSat y de las perturbaciones esperadas en órbita. | Completar el modelo de masa del satélite y estimar sus momentos de inercia para seleccionar la variante definitiva de ruedas de reacción.
TBD-05 | Compatibilidad S-band de la estación terrestre | La arquitectura propuesta requiere un enlace de alta velocidad para la descarga de datos científicos. | Verificar que la estación terrestre de referencia pueda operar en la banda y características del transmisor seleccionado, o definir las modificaciones necesarias.
TBD-06 | Distribución física definitiva de los módulos | Aunque el presupuesto volumétrico es preliminarmente viable, la geometría de algunos componentes puede impedir su integración práctica. | Desarrollar un modelo CAD del CubeSat con PCBs, cámara, batería, antenas, ADCS, conectores y separadores.
TBD-07 | Gestión térmica de los elementos de mayor consumo | El transmisor S-band, reguladores y actuadores pueden generar concentraciones locales de calor durante los modos de máxima actividad. | Realizar un modelo térmico preliminar y verificar rutas de conducción hacia la estructura del CubeSat.
TABLA 14: Matriz preliminar de riesgos técnicos del CubeSat UD34.
X p{1.5cm} p{1.5cm} X} ID | Riesgo | Probabilidad | Impacto | Estrategia preliminar de mitigación
ID | Riesgo | Probabilidad | Impacto | Estrategia preliminar de mitigación
RSK-01 | La generación solar real resulta inferior a la requerida por el presupuesto energético orbital. | Media | Alto | Optimizar los modos de operación, reducir ciclos de actividad de cargas de alto consumo y revisar la cantidad o disposición de celdas solares.
RSK-02 | Los módulos seleccionados no pueden integrarse físicamente dentro del volumen disponible de 1U. | Media | Alto | Realizar integración CAD antes del diseño final de PCBs y sustituir componentes por alternativas más compactas si fuese necesario.
RSK-03 | La estación terrestre no dispone de un enlace S-band compatible con el sistema de comunicaciones propuesto. | Media | Alto | Verificar tempranamente las capacidades de la estación terrestre y mantener alternativas de comunicación o adaptación del segmento terreno.
RSK-04 | La carga útil genera más información de la prevista debido a la configuración multiespectral definitiva. | Media | Medio | Dimensionar memoria con margen, implementar compresión y ajustar el número de adquisiciones de acuerdo con la capacidad real del enlace descendente.
RSK-05 | Interferencia electromagnética o magnética afecta las mediciones del ADCS. | Media | Alto | Separar físicamente el magnetómetro de transmisores, convertidores, actuadores y corrientes elevadas; revisar el layout y realizar calibración del sistema integrado.
RSK-06 | Bloqueo o corrupción temporal del OBC debido a eventos de radiación. | Baja--Media | Alto | Utilizar un procesador con tolerancia a radiación, watchdog independiente, memorias con mecanismos de detección/corrección de errores y modos de recuperación segura.
RSK-07 | Sobretemperatura durante periodos de transmisión S-band o alta actividad del ADCS. | Media | Medio--Alto | Limitar duración continua de modos de alta potencia, mejorar conducción térmica hacia la estructura y verificar temperaturas mediante análisis y pruebas térmicas.
RSK-08 | Pérdida temporal del control de actitud impide apuntar correctamente la cámara o la antena S-band. | Media | Alto | Mantener sensores redundantes en principio de medida, utilizar magnetorquers para recuperación y definir un modo seguro de actitud.
