UFelipeJR/CubeSat_UD34/Archivos/02_BOM_y_Costos/Cotizaciones_20_referencias.xlsx

Sheet: Cotizaciones_20
Componente | Designadores | Cant./tarjeta | Fabricante | MPN | Proveedor | URL proveedor | Precio unit. 10 USD | Precio unit. 100 USD | Precio unit. 1000 USD | Lote 10 USD | Lote 100 USD | Lote 1000 USD
50m | R1 | 1 | Vishay | WSL2512R0500FEA | DigiKey | https://www.digikey.com/en/products/detail/vishay-dale/WSL2512R0500FEA/712568 | 0.40 | 0.27 | 0.22 | 3.98 | 27.39 | 216.34
61300211121 | JP1, JP2, JP701 | 3 |  | 61300211121 | DigiKey | https://www.digikey.com/en/products/detail/w%C3%BCrth-elektronik/61300211121/4846823 | 0.09 | 0.07 | 0.07 | 2.68 | 20.88 | 208.80
61300311121 | J2 | 1 |  | 61300311121 | DigiKey | https://www.digikey.com/en/products/detail/wurth-electronics-inc/61300311121/732-5316-ND/4846825 | 0.11 | 0.08 | 0.08 | 1.07 | 8.48 | 84.80
ESQ-126-39-G-D | H1, H2 | 2 |  | ESQ-126-39-G-D | DigiKey | https://www.digikey.com/en/products/detail/samtec-inc/ESQ-126-39-G-D/3601055 | 11.73 | 9.51 | 6.04 | 234.60 | 1901.20 | 12072.50
FH12-30S-0.5SH(55) | J501 | 1 |  | FH12-30S-0.5SH(55) | LCSC | https://www.lcsc.com/product-image/C506793.html | 0.58 | 0.46 | 0.40 | 5.78 | 45.83 | 400.80
FTSH-105-01-L-DV-K | J1 | 1 |  | FTSH-105-01-L-DV-K | DigiKey | https://www.digikey.com/en/products/detail/samtec-inc/FTSH-105-01-L-DV-K/1875039 | 1.37 | 1.07 | 0.75 | 13.70 | 107.50 | 753.00
INA226AIDGSR | U2 | 1 |  | INA226AIDGSR | DigiKey | https://www.digikey.com/en/products/detail/texas-instruments/INA226AIDGSR/2687118 | 2.10 | 1.72 | 1.50 | 20.97 | 171.86 | 1496.34
IS42S32160F-6BLI | U201 | 1 |  | IS42S32160F-6BLI | LCSC | https://www.lcsc.com/product-detail/C1348852.html | 14.97 | 12.87 | 12.87 | 149.65 | 1286.59 | 12865.90
MX52LM08A11XVI | U302 | 1 |  | MX52LM08A11XVI | DigiKey | https://www.digikey.com/en/products/detail/macronix/MX52LM08A11XVI/25824295 | 75.47 | 71.17 | 71.17 | 754.69 | 7116.70 | 71167.00
PCA9306DCUR | U501 | 1 |  | PCA9306DCUR | DigiKey | https://www.digikey.com/en/products/detail/texas-instruments/PCA9306DCUR/768360 | 0.65 | 0.52 | 0.46 | 6.54 | 51.78 | 460.59
SN74AVC4T774PWR | U502 | 1 |  | SN74AVC4T774PWR | DigiKey | https://www.digikey.com/en/products/detail/texas-instruments/SN74AVC4T774PWR/1902131 | 1.11 | 0.90 | 0.83 | 11.13 | 89.75 | 827.72
STM32N657X0H3Q | U8 | 1 |  | STM32N657X0H3Q | Mouser | https://www.mouser.com/en/ProductDetail/STMicroelectronics/STM32N657X0H3Q | 18.19 | 17.43 | 16.42 | 181.90 | 1743.00 | 16420.00
TCA4307DGKR | U603_I2C_ADCS, U603_I2C_SYS | 2 |  | TCA4307DGKR | DigiKey | https://www.digikey.com/en/products/detail/texas-instruments/TCA4307DGKR/13169411 | 2.44 | 2.01 | 1.88 | 48.84 | 402.74 | 3757.68
TCAN334GDR | U601_CAN_A, U601_CAN_B | 2 |  | TCAN334GDR | DigiKey | https://www.digikey.com/es/products/detail/texas-instruments/TCAN334GDR/9462796 | 2.37 | 1.95 | 1.82 | 47.44 | 390.86 | 3641.48
TLV75518PDBVR | U4, U5 | 2 |  | TLV75518PDBVR | DigiKey | https://www.digikey.com/en/products/detail/texas-instruments/TLV75518PDBVR/9685549 | 0.29 | 0.23 | 0.19 | 5.86 | 45.20 | 381.60
TMP117AIDRVR | U702 | 1 | Texas Instruments | TMP117AIDRVR | DigiKey | https://www.digikey.com/en/products/detail/texas-instruments/TMP117AIDRVR/9685284 | 4.78 | 4.21 | 3.79 | 47.83 | 420.52 | 3791.34
TPS3851G18EDRBR | U701 | 1 |  | TPS3851G18EDRBR | DigiKey | https://www.digikey.com/en/products/detail/texas-instruments/TPS3851G18EDRBR/6570205 | 1.04 | 0.84 | 0.75 | 10.43 | 83.85 | 746.64
TPS22918DBVR | U6, U7 | 2 |  | TPS22918DBVR | DigiKey | https://www.digikey.com/en/products/detail/texas-instruments/TPS22918DBVR/5994601 | 0.39 | 0.30 | 0.26 | 7.80 | 60.76 | 516.94
TPS62130ARGTR | U3 | 1 | Texas Instruments | TPS62130ARGTR | DigiKey | https://www.digikey.com/en/products/detail/texas-instruments/TPS62130ARGTR/4307640 | 1.70 | 1.38 | 1.19 | 16.98 | 138.28 | 1190.34
TPS259470ARPWR | U1 | 1 |  | TPS259470ARPWR | DigiKey | https://www.digikey.com/en/products/detail/texas-instruments/TPS259470ARPWR/14123984 | 1.34 | 1.08 | 0.97 | 13.37 | 108.08 | 973.08
Total de referencias con precio |  |  |  |  |  |  |  |  |  | 1585.24 | 14221.25 | 131972.89
Costo por tarjeta (muestra) |  |  |  |  |  |  |  |  |  | 158.52 | 142.21 | 131.97

Sheet: Resumen_20
Lote de OBC | Cantidad tarjetas | Subtotal USD | Subtotal por tarjeta USD
Lote de 10 | 10 | 1585.24 | 158.52
Lote de 100 | 100 | 14221.25 | 142.21
Lote de 1000 | 1000 | 131972.89 | 131.97
Cobertura del análisis | 20 referencias con precio público de 67 grupos exportados de Altium
Alcance económico | Subtotal de componentes cotizados, sin fabricación de PCB, ensamblaje, envíos ni impuestos.
