UFelipeJR/CubeSat_UD34/Archivos/05_Esquematicos/OBC.pdf

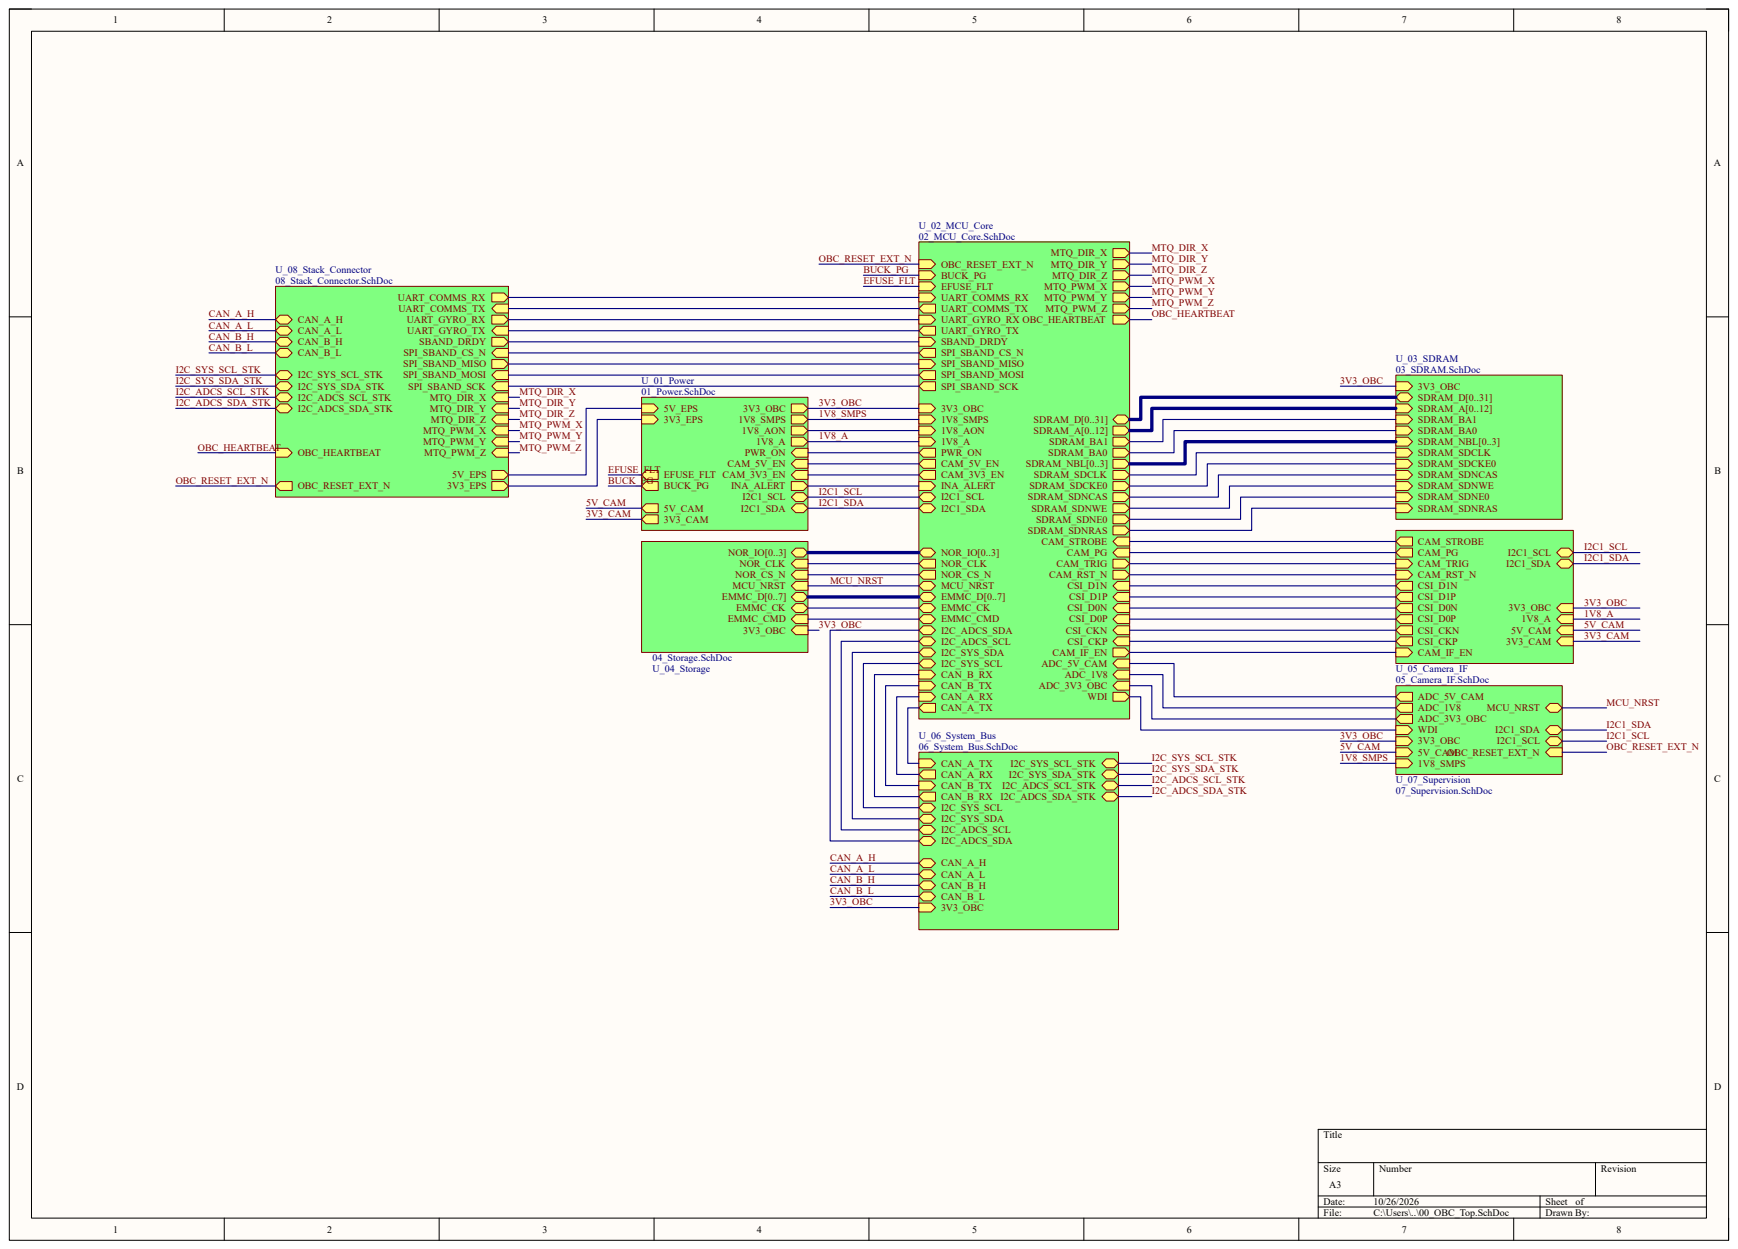
[picture p6: page 1]
Title; Size; Number; Revision; Date:; Sheet of; File:; C:\Users\..\00_OBC_Top.SchDoc; Drawn By:; 3V3_OBC 1V8_SMPS 1V8_AON 1V8_A PWR_ON CAM_5V_EN CAM_3V3_EN; BUCK_PG; INA_ALERT; I2C1_SCL I2C1_SDA; 5V_EPS 3V3_EPS; 3V3_CAM; 5V_CAM; EFUSE_FLT; U_01_Power 01_Power.SchDoc; 3V3_OBC; INA_ALERT I2C1_SCL I2C1_SDA; 1V8_SMPS 1V8_AON; PWR_ON CAM_5V_EN CAM_3V3_EN; SDRAM_D[0..31] SDRAM_A[0..12] SDRAM_BA1 SDRAM_BA0 SDRAM_NBL[0..3] SDRAM_SDCLK; SDRAM_SDNCAS; SDRAM_SDCKE0; SDRAM_SDNWE SDRAM_SDNE0 SDRAM_SDNRAS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
