UFelipeJR/CubeSat_UD34/Archivos/05_Esquematicos/Power.pdf

# GND ¹ ²

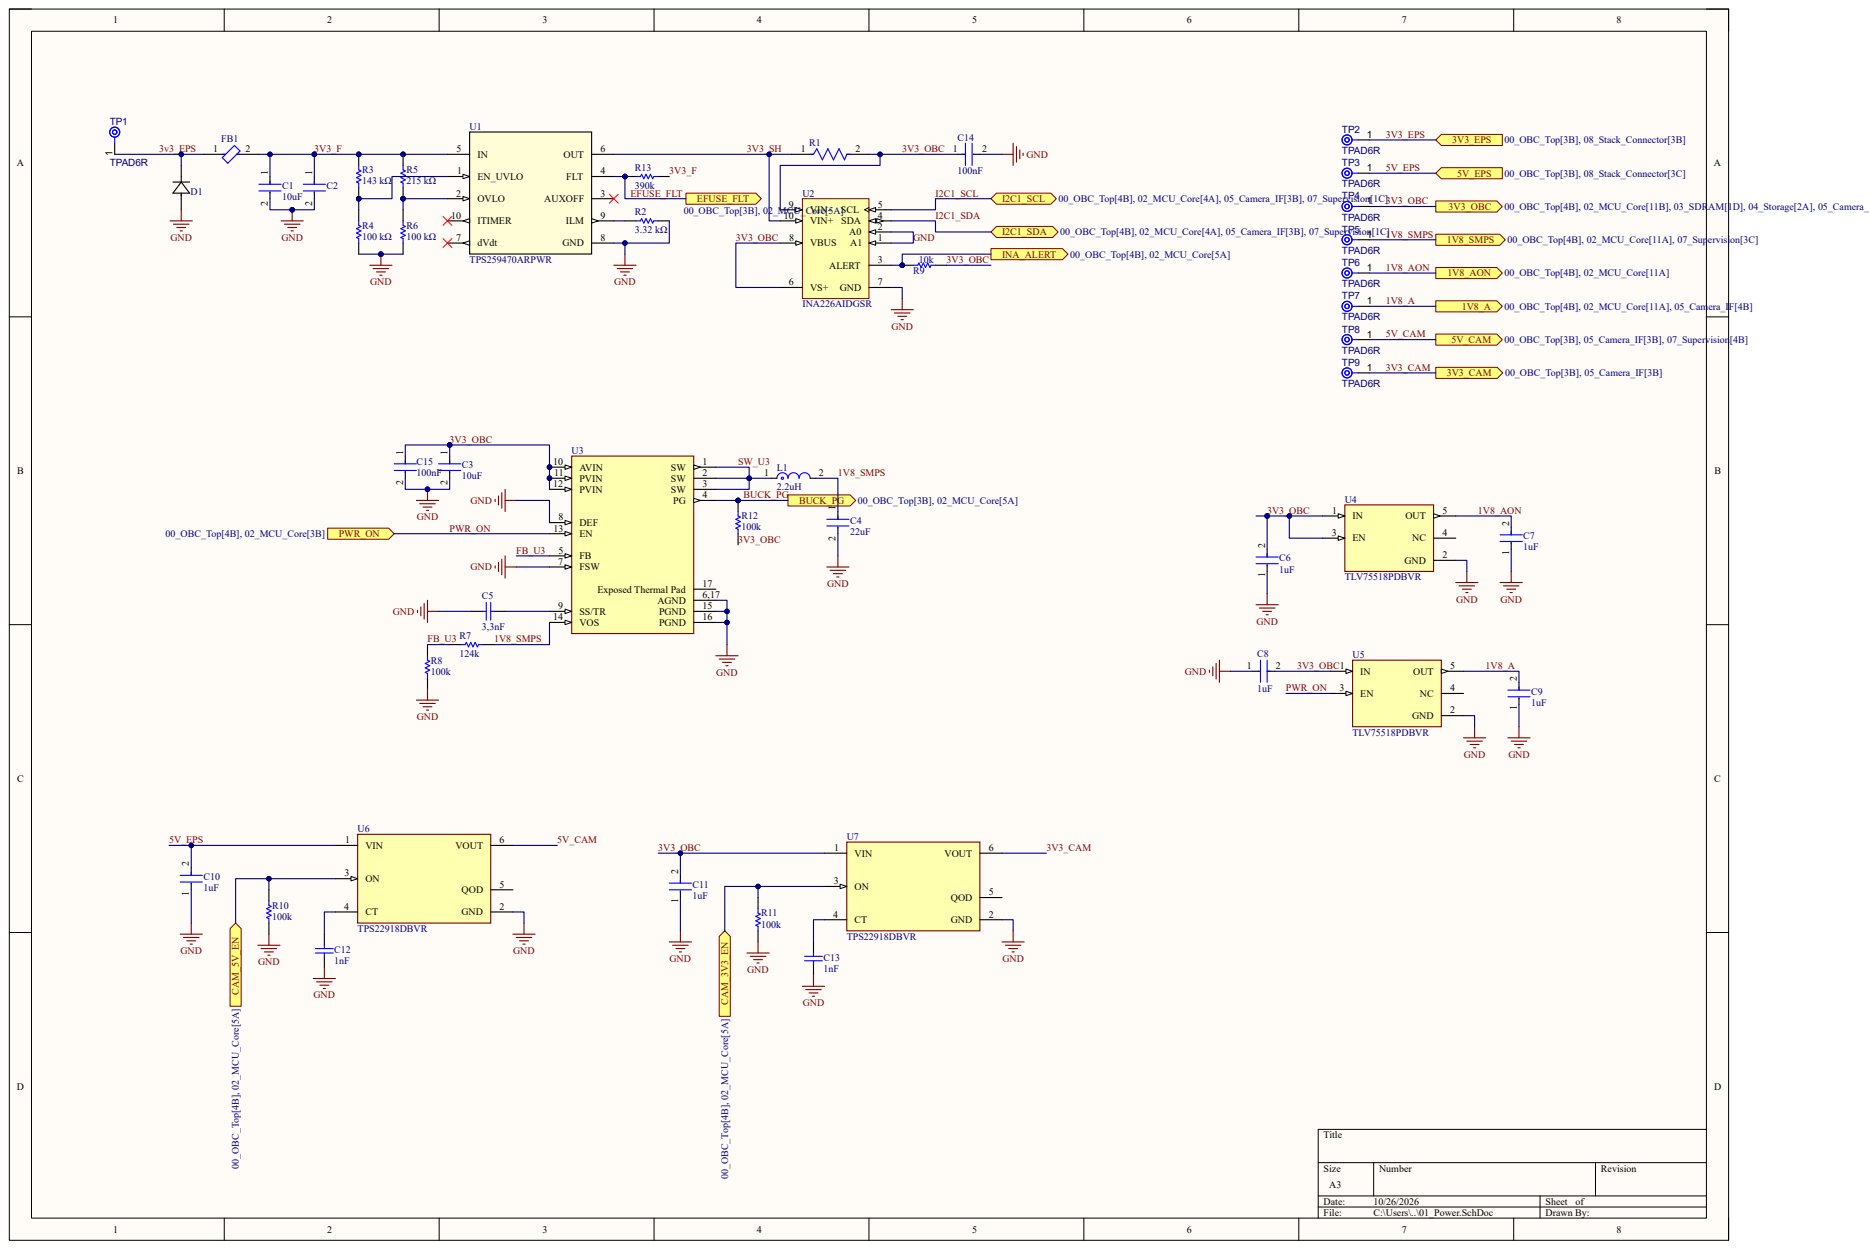
[picture p7: page 1]
