UFelipeJR/CubeSat_UD34/Archivos/05_Esquematicos/Stack_Connector.pdf

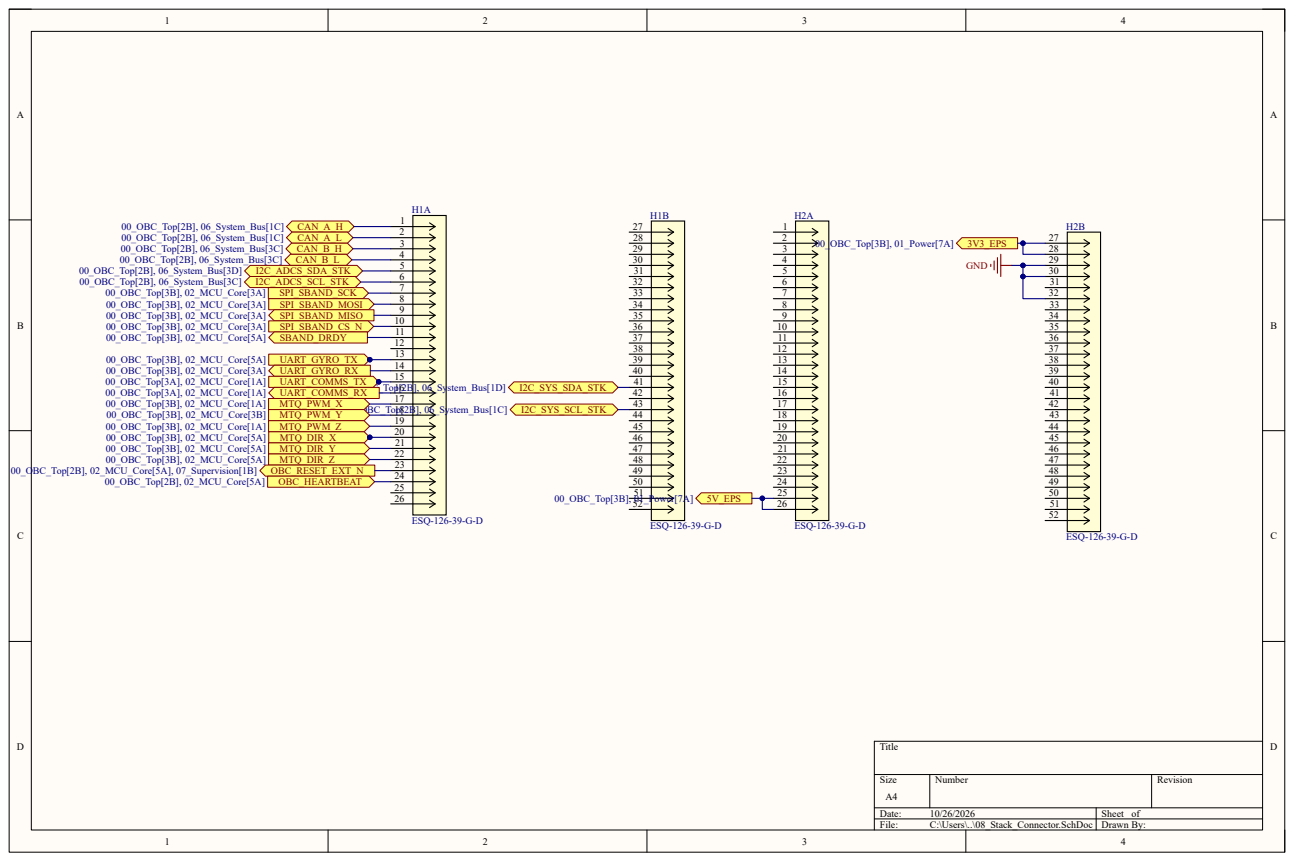
[picture p8: page 1]
Title; Size; Number; Revision; Date:; Sheet of; File:; C:\Users\..\08_Stack_Connector.SchDoc; Drawn By:; ESQ-126-39-G-D; 00_OBC_Top[3B], 01_Power[7A]; 5V_EPS; 3V3_EPS; GND; 00_OBC_Top[2B], 06_System_Bus[1C]; I2C_SYS_SCL_STK; 00_OBC_Top[2B], 06_System_Bus[1D]; I2C_SYS_SDA_STK; CAN_A_H; CAN_A_L; 00_OBC_Top[2B], 06_System_Bus[3C]; CAN_B_H; CAN_B_L; I2C_ADCS_SCL_STK; 00_OBC_Top[2B], 06_System_Bus[3D]; I2C_ADCS_SDA_STK; 00_OBC_Top[3B], 02_MCU_Core[3A]; SPI_SBAND_SCK; SPI_SBAND_MOSI; SPI_SBAND_MISO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
