UFelipeJR/CubeSat_UD34/Archivos/05_Esquematicos/System_bus.pdf

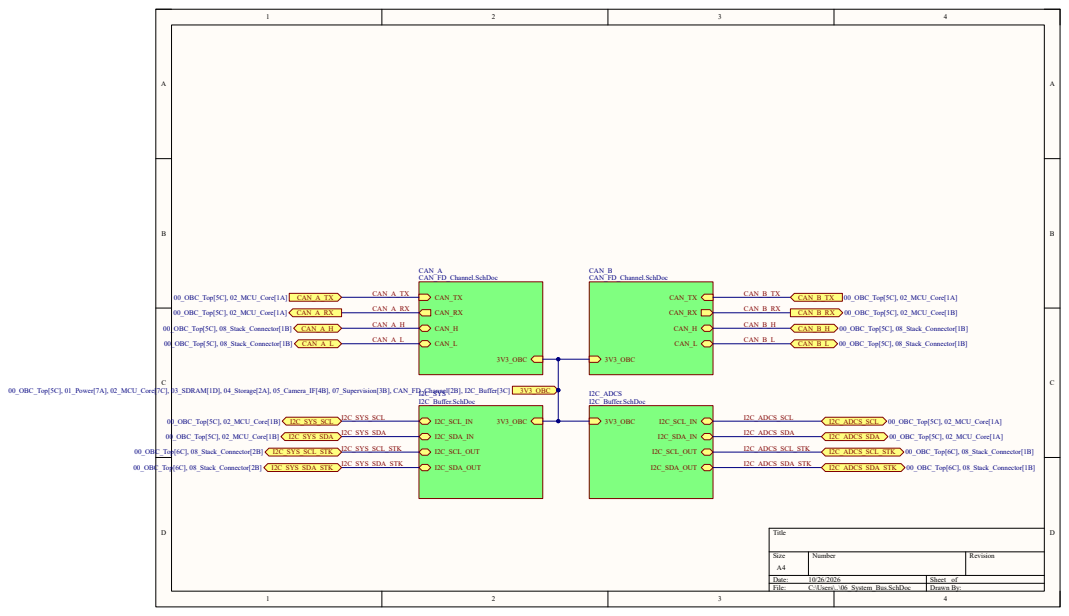
[picture p9: page 1]
Title; Size; Number; Revision; Date:; Sheet of; File:; C:\Users\..\06_System_Bus.SchDoc; Drawn By:; 3V3_OBC; CAN_TX; CAN_RX; CAN_H; CAN_L; CAN_A CAN_FD_Channel.SchDoc; CAN_B CAN_FD_Channel.SchDoc; CAN_A_TX; CAN_A_RX; CAN_A_H; CAN_A_L; CAN_B_TX; CAN_B_RX; CAN_B_H; CAN_B_L; 00_OBC_Top[5C], 02_MCU_Core[1A]; 00_OBC_Top[5C], 02_MCU_Core[1B]; 00_OBC_Top[5C], 08_Stack_Connector[1B]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

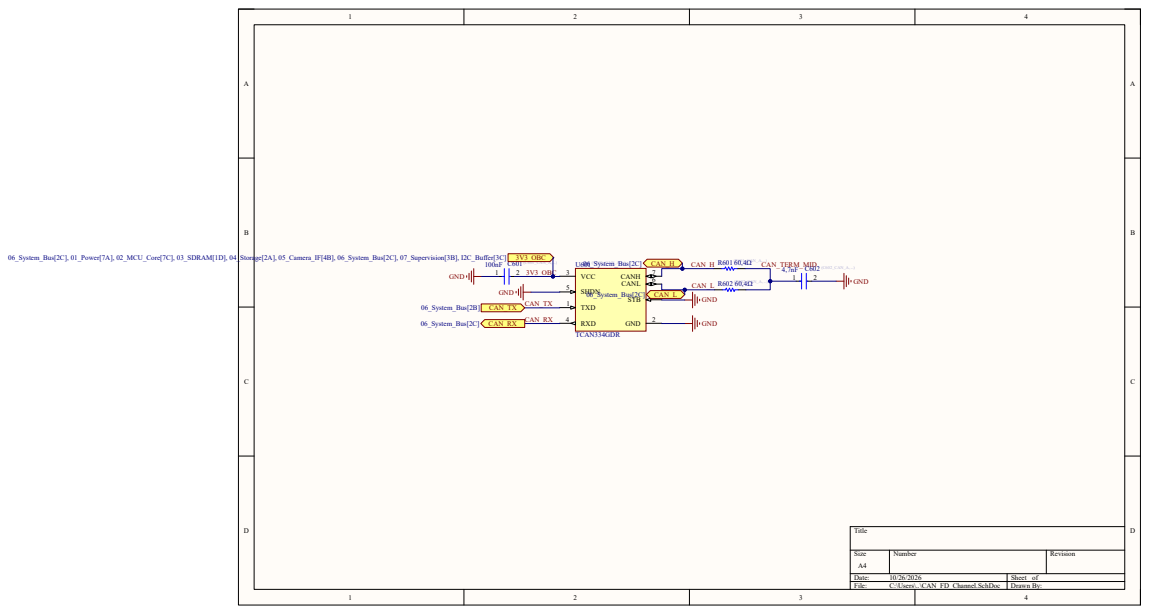
[picture p10: page 2]
Title; Size; Number; Revision; Date:; Sheet of; File:; C:\Users\..\CAN_FD_Channel.SchDoc; Drawn By:; VCC 3; CANH; CANL; RXD 4; SHDN 5; STB; TXD 1; GND; U601⁽U601_CAN_A, ...); TCAN334GDR; CAN_RX; 3V3_OBC; CAN_TX; CAN_L; CAN_H; C601⁽C601_CAN_A, ...) 100nF; R601⁽R601_CAN_A, ...) 60,4Ω; R602 ⁽R602_CAN_A, ...) 60,4Ω; CAN_TERM_MID; (C602_CAN_A, ...) 4,7nF; 06_System_Bus[2B] CAN_TX; 06_System_Bus[2C] CAN_RX; 06_System_Bus[2C] CAN_H; 06_System_Bus[2C] CAN_L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

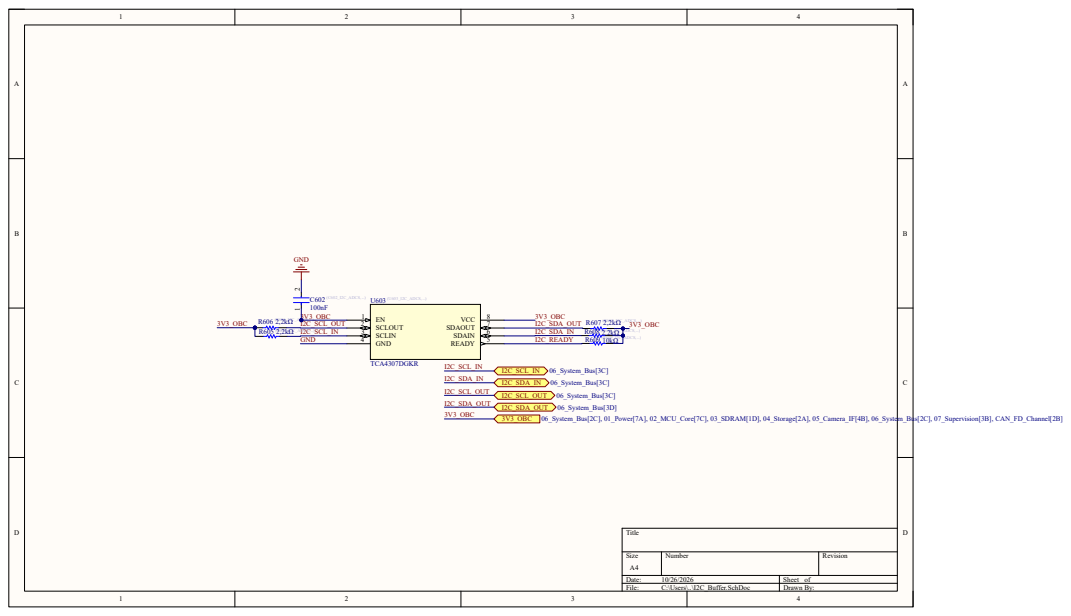
[picture p11: page 3]
Title; Size; Number; Revision; Date:; Sheet of; File:; C:\Users\..\I2C_Buffer.SchDoc; Drawn By:; EN 1 SCLOUT 2 SCLIN 3; GND 4; READY; SDAIN; SDAOUT; VCC; U603 ⁽U603_I2C_ADCS, ...); TCA4307DGKR; 3V3_OBC I2C_SCL_OUT I2C_SCL_IN GND; 3V3_OBC I2C_SDA_OUT I2C_SDA_IN I2C_READY; R605 ⁽R605_I2C_ADCS, ...) 2,2kΩ; R606 ⁽R606_I2C_ADCS, ...) 3V3_OBC; (R607_I2C_ADCS, ...) 2,2kΩ; (R608_I2C_ADCS, ...) 2,2kΩ; 3V3_OBC; (R609_I2C_ADCS, ...) 10kΩ ¹ ²; C602 ⁽C602_I2C_ADCS, ...) 100nF; GND; I2C_SCL_IN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
