UFelipeJR/CubeSat_UD34/Archivos/05_Esquematicos/Camara.pdf

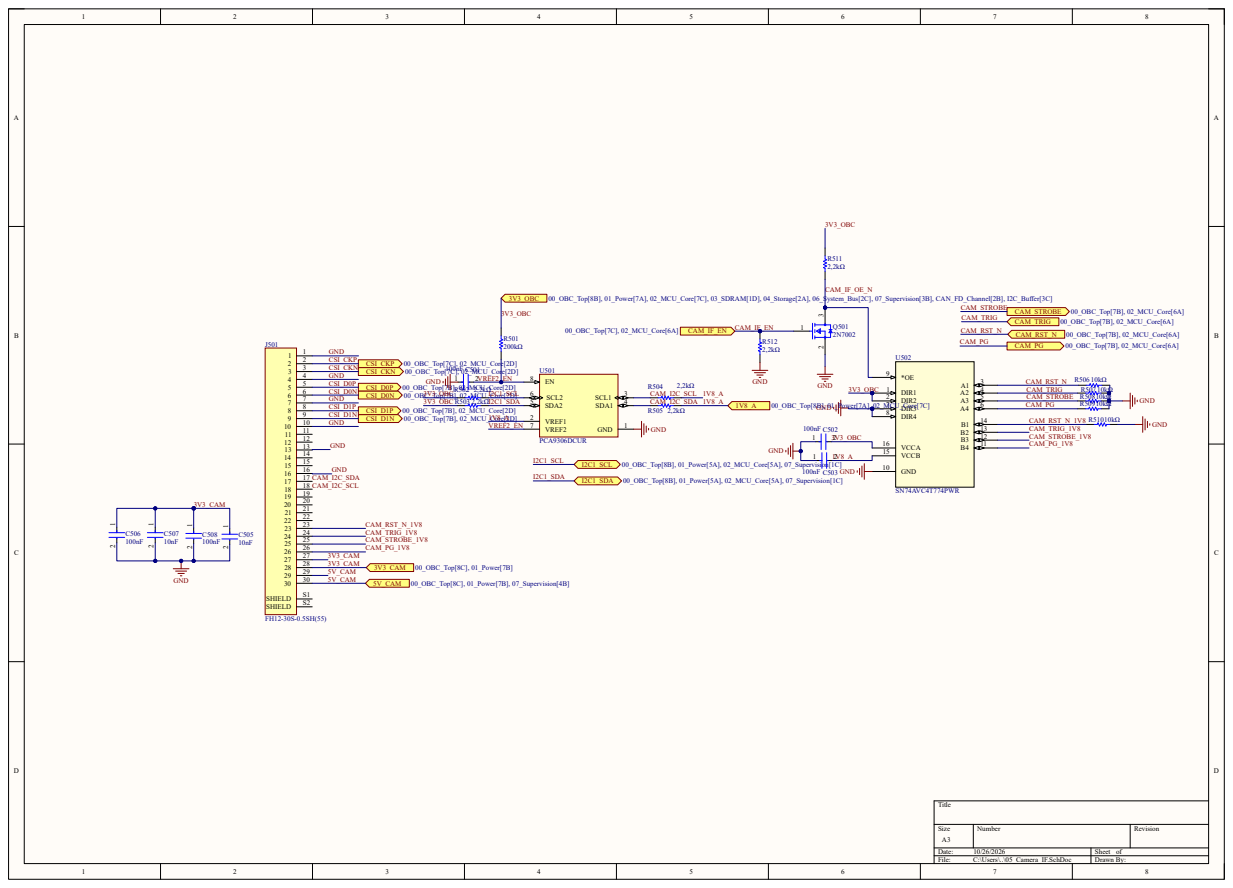
[picture p12: page 1]
