UFelipeJR/CubeSat_UD34/Archivos/05_Esquematicos/MCU.pdf

# 8,2pF ¹ ²

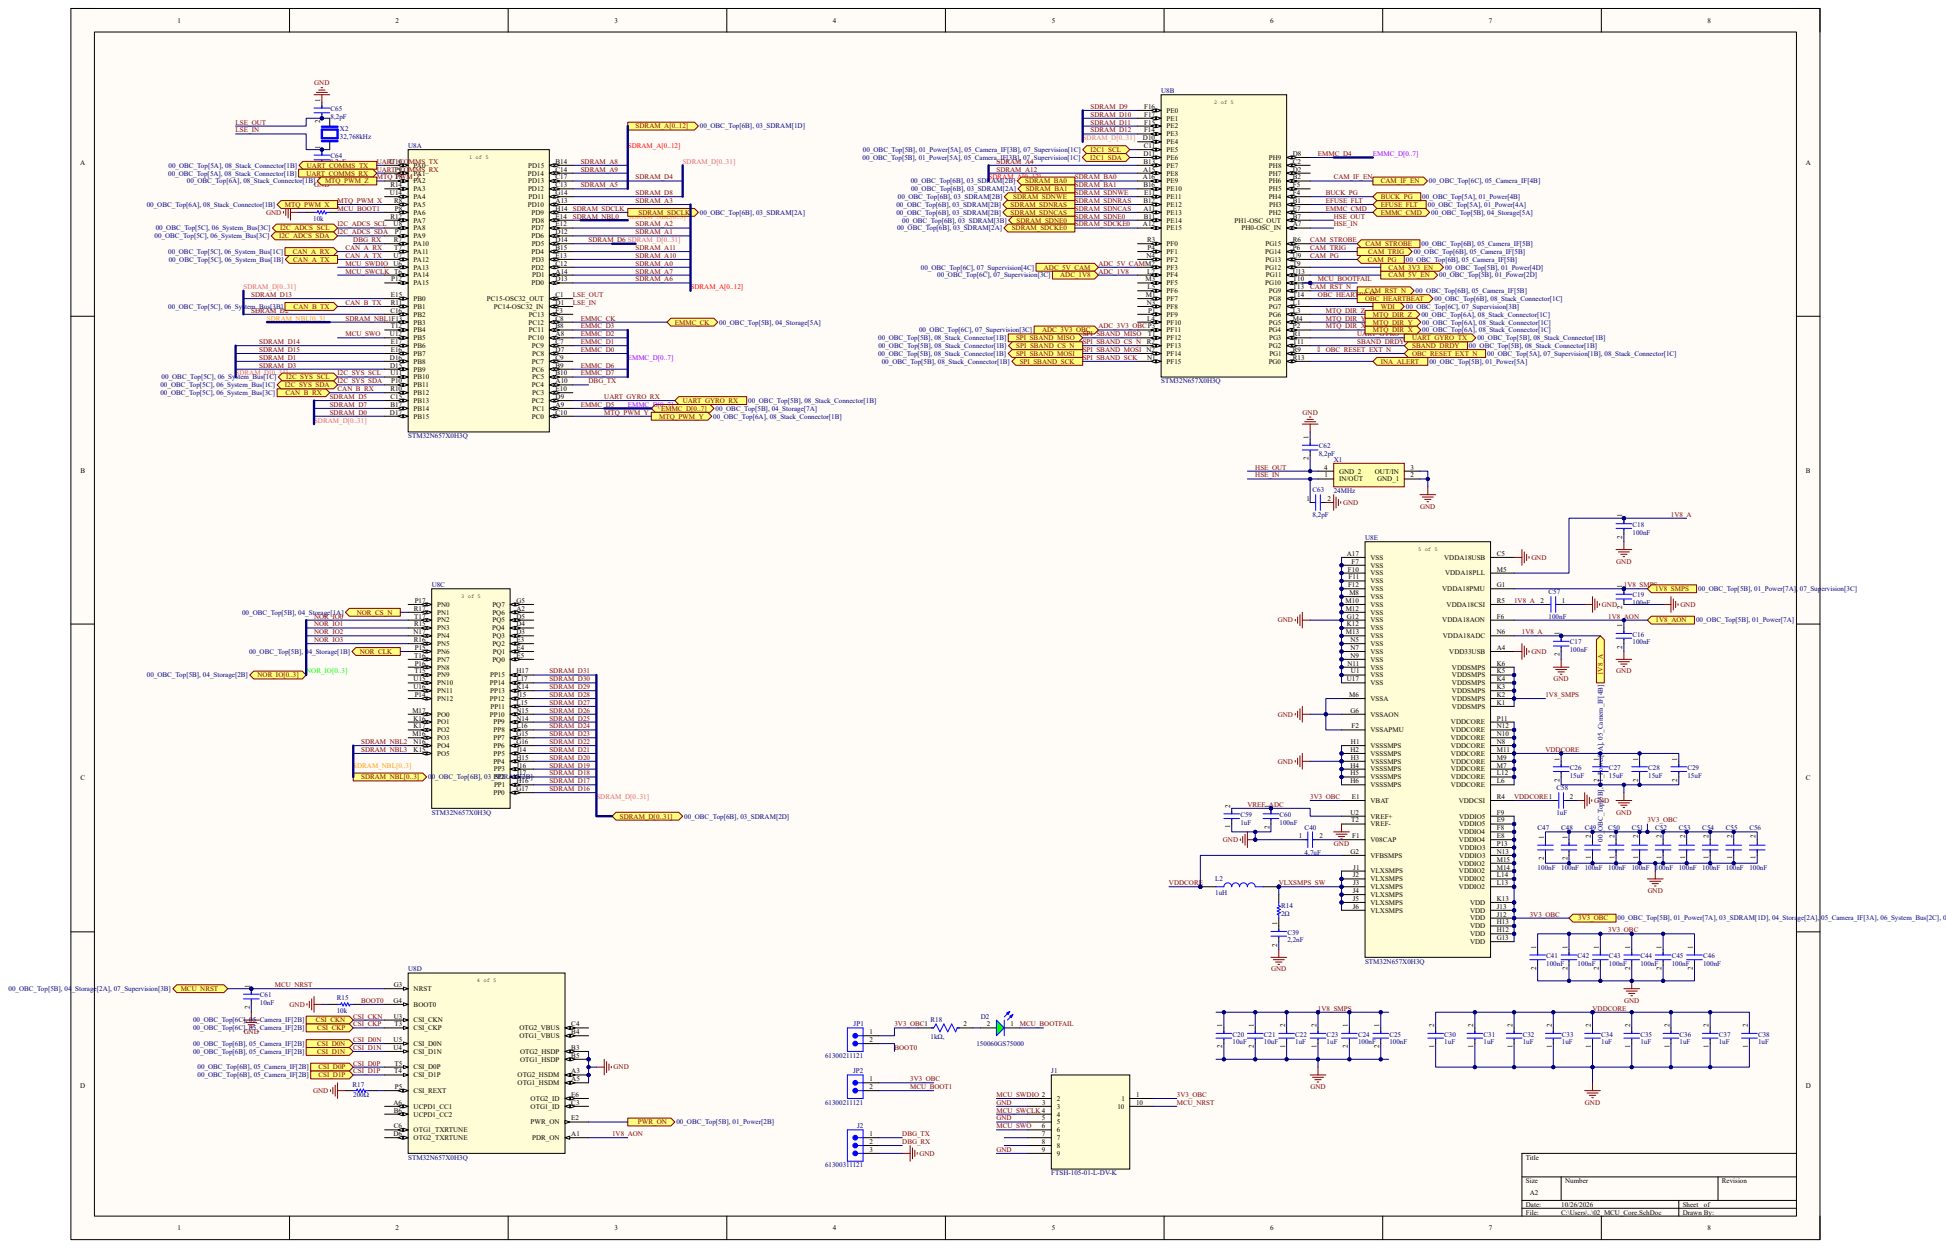
[picture p13: page 1]
