UFelipeJR/CubeSat_UD34/Archivos/05_Esquematicos/SDRAM.pdf

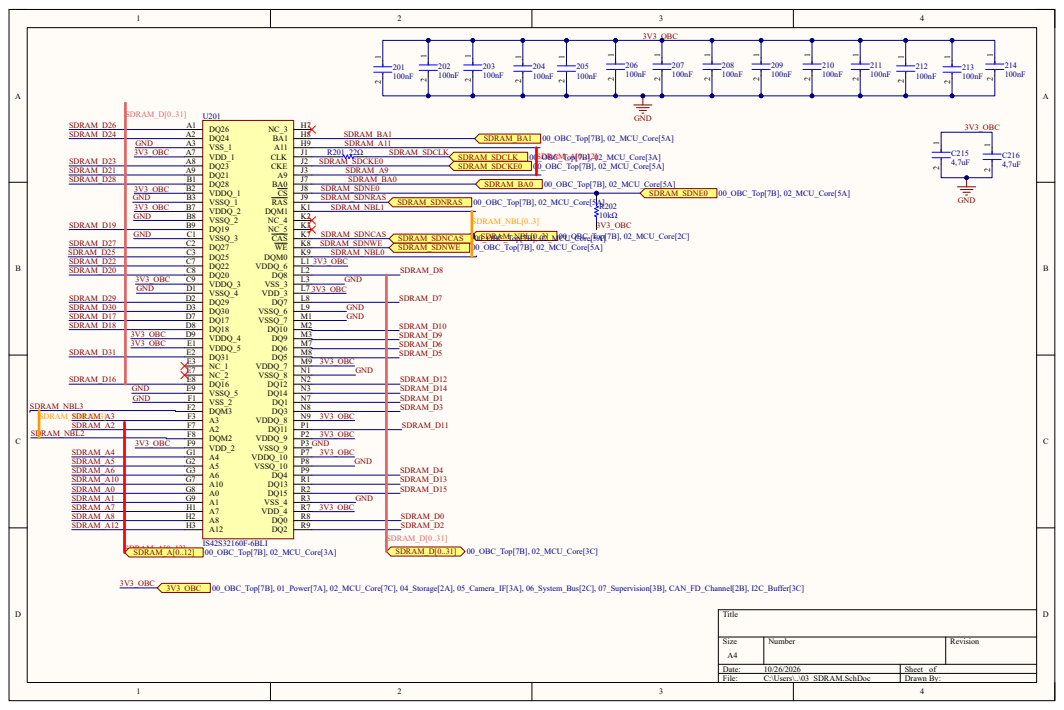
[picture p14: page 1]
