UFelipeJR/CubeSat_UD34/Archivos/05_Esquematicos/Storage.pdf

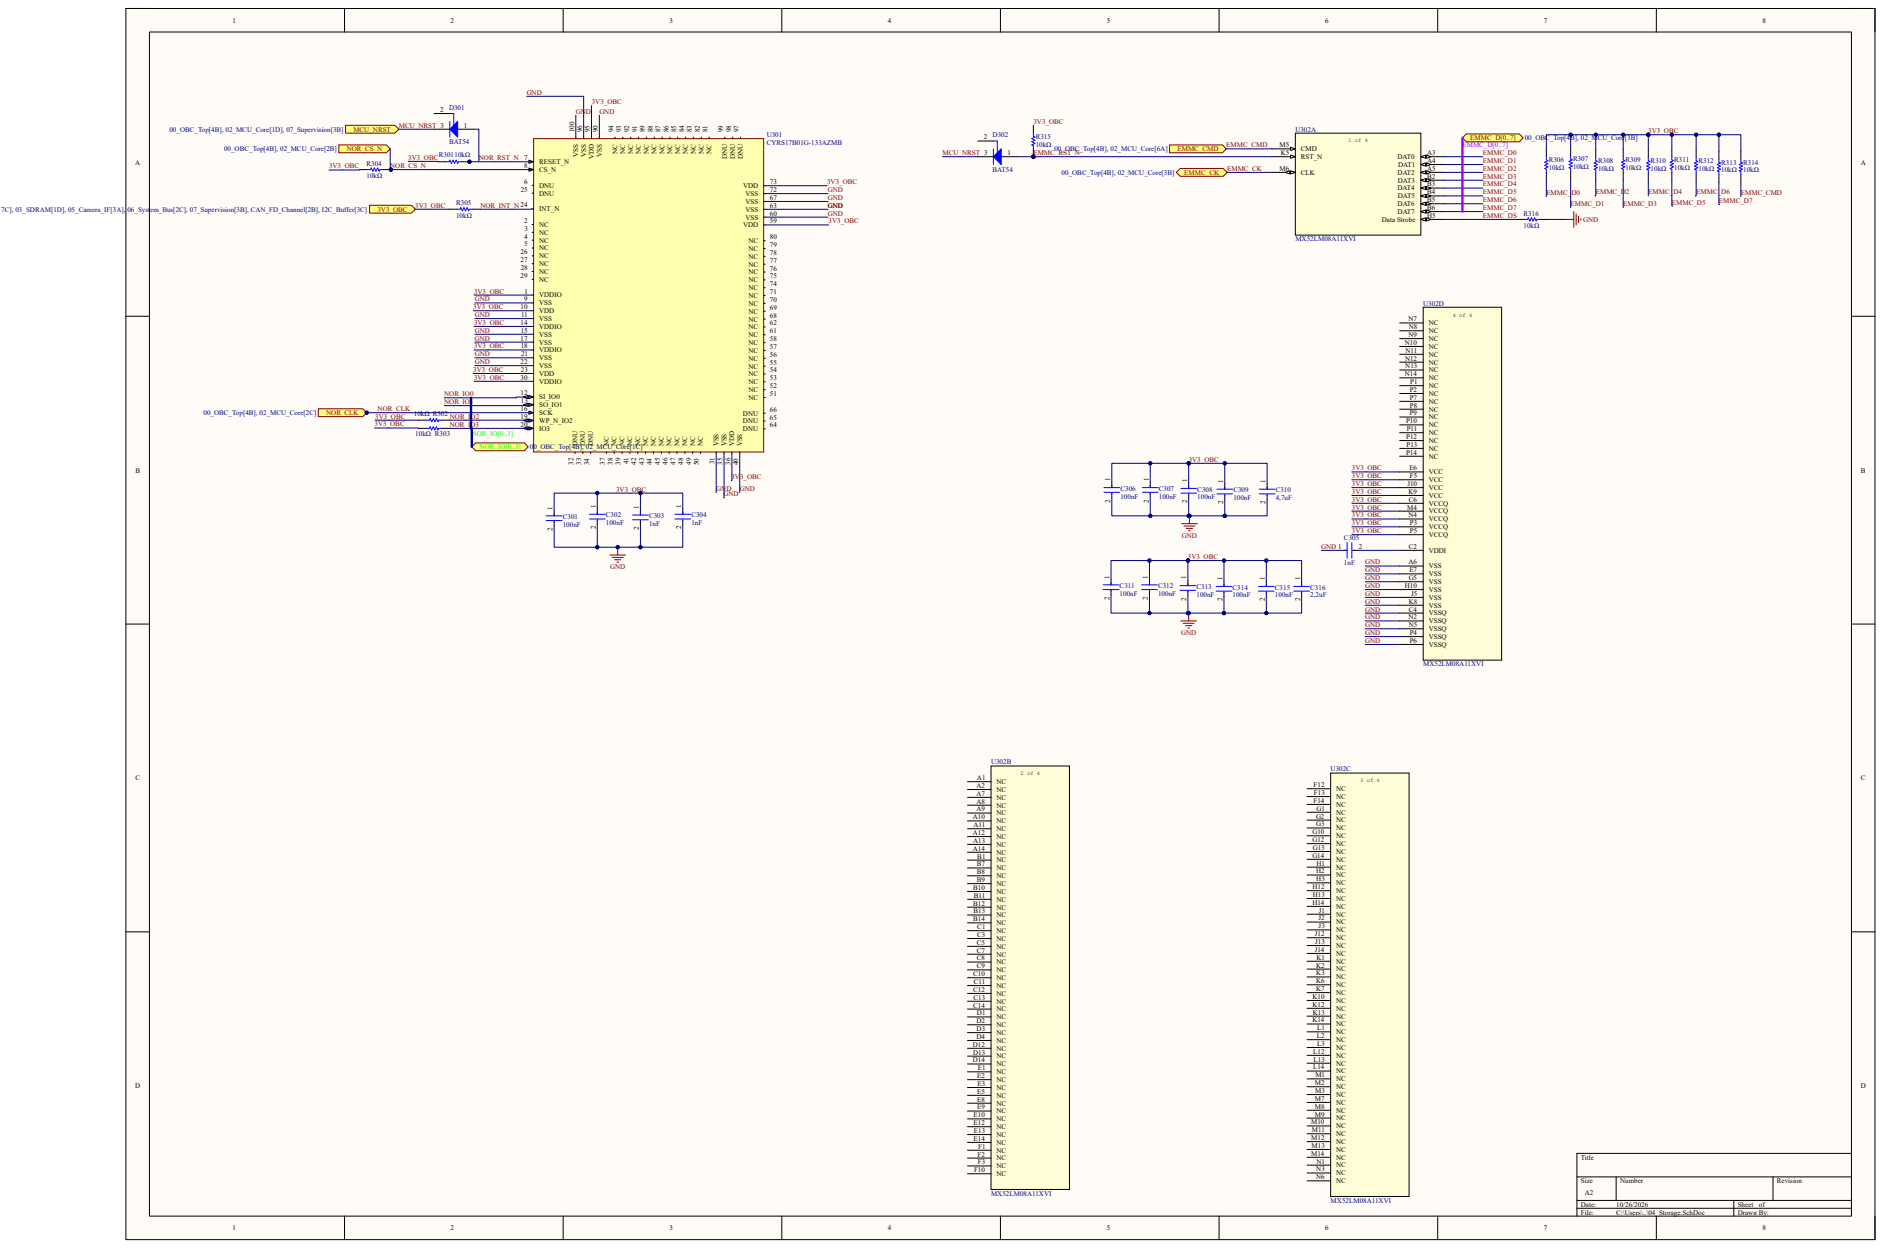
[picture p15: page 1]
