UFelipeJR/CubeSat_UD34/Archivos/05_Esquematicos/Supervision.pdf

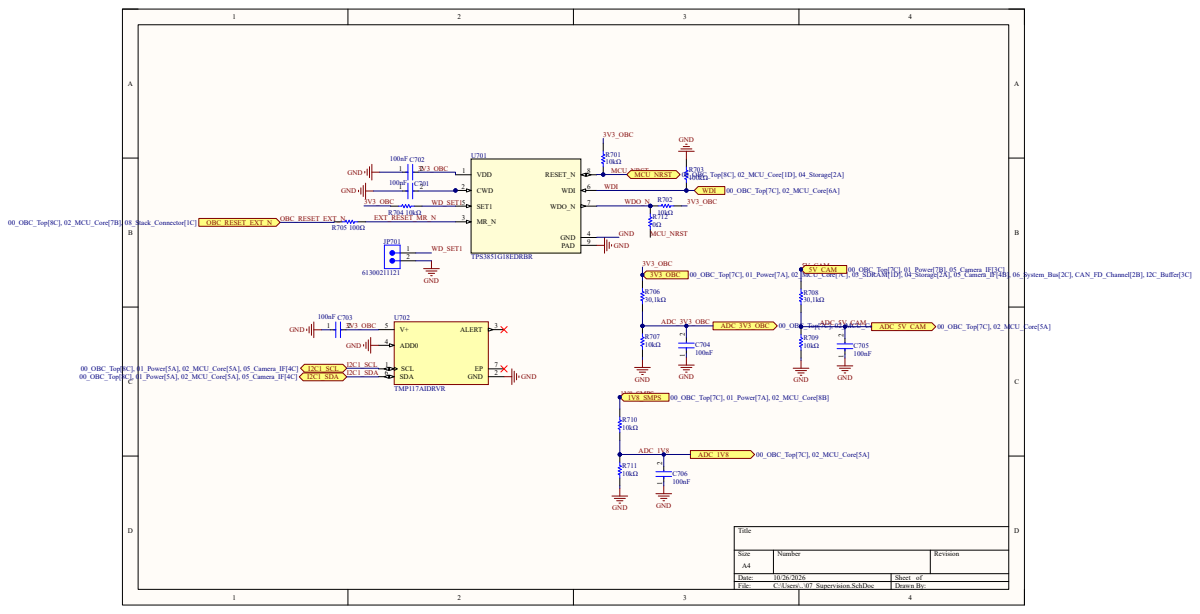
[picture p16: page 1]
