UFelipeJR/CubeSat_UD34/(list of files, drawings)

Other design files:
Archivos/04_Librerias/Librerias/CYRS17B01G.SchLib
Archivos/04_Librerias/Librerias/CYRS17B01G_100TQFP.PcbLib
